SolarInvert-GmbH/inverter_assemblies--powerboard/Sonderteile und Unterbaugruppen/HF Trafo/HF-Trafo RM5 DMBÜ NV_1443021f_CT872001.pdf

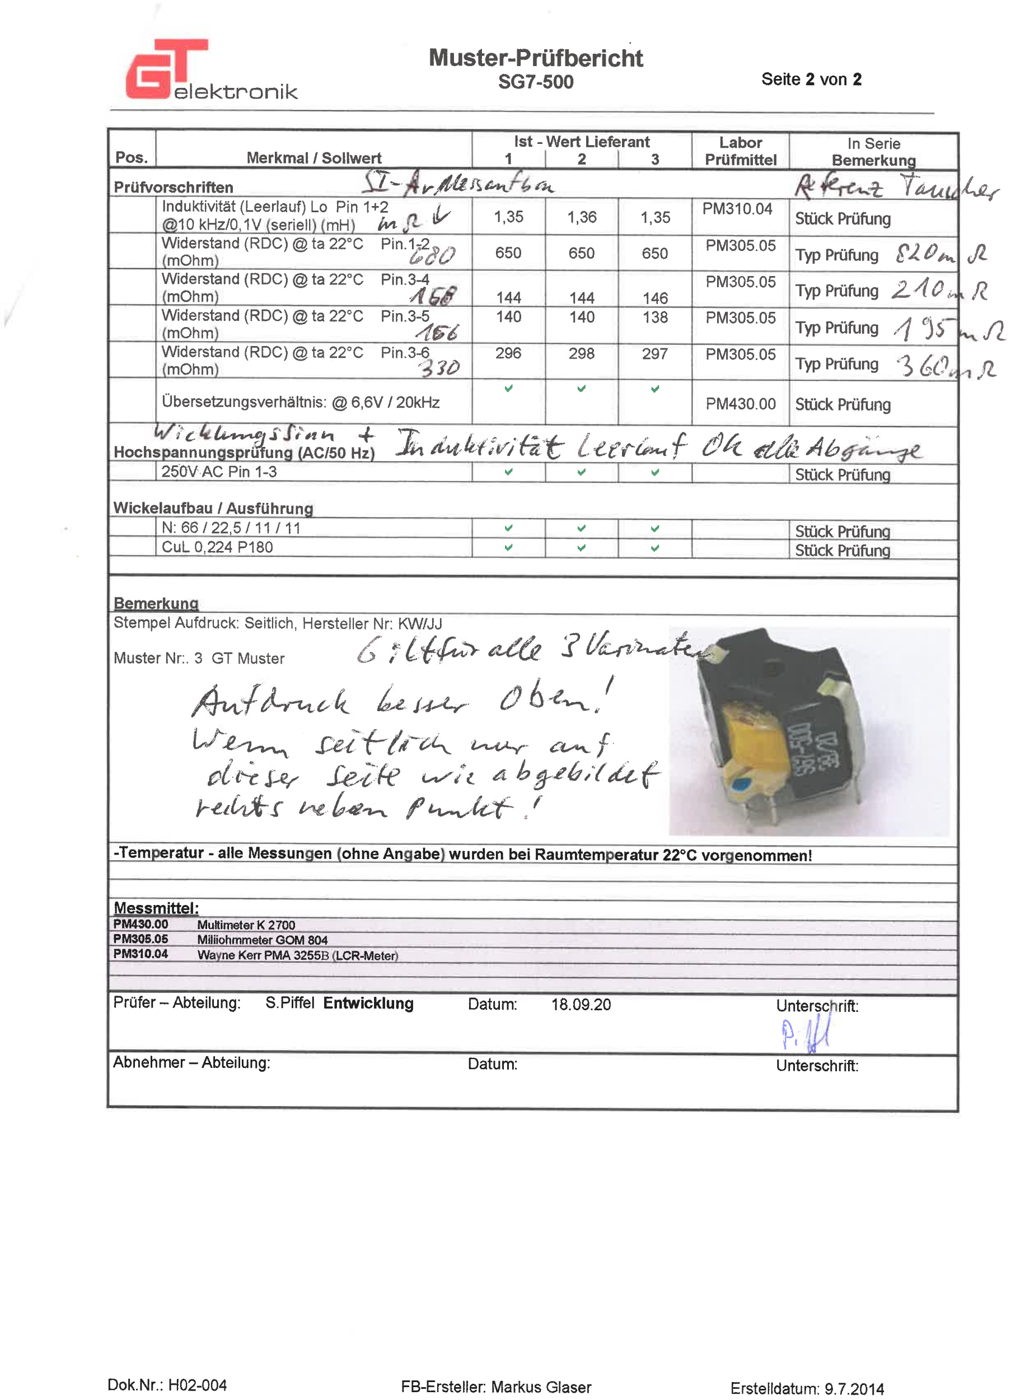
[picture p4: page 1]
