SolarInvert-GmbH/inverter_assemblies--powerboard/Stückliste SOL 2600-60 Leistungsplatine CT902670.017.xls

CT902670 |  | zuletzt gespeichert: | 29.09.2022 |  |  |  |  | Letzte Änderung in | 017
Bestück-Pos. | Menge | Artikel-Name | Artikel-Werte | Bauform | Toleranz | Hersteller | Artikel-Bezeichnung | CT Art.Nr. | Änd-index | Bemerkungen
Leiterkarte | 1 | Leiterkarte Leistungsplatine |  |  |  |  | SI3002V41 | CT300241 | 000 | SMD vorbestückte Leiterplatte Typ NV verwenden
B1 | 0 | SMD- Gleichrichter |  |  |  |  |  |  |  | Wird nur bestückt wenn TR300 bestückt wird
C323 | 1 | Keramik Kondensator | 1nF / 200V | RM5 | +-20% | frei |  | CT851008 | 000 | RoE 20 00 123 8, By2176700; besser den bei C323 generell
 | 0 | Keramik Kondensator | 1nF / 400V | RM5 | +-20% | frei |  | CT851009 |  | RoE 20 03 036 4; Alternativ zu C323
 | 0 | Keramik Kondensator | 1nF /250V | RM5 | +-20% | frei |  | CT851006 |  | Alternativ zu C323
 | 0 | Keramik Kondensator | 1nF / 100V | RM5 | +-20% | frei |  | CT856020 |  | alternativ zu C323 (Freigabe erforderlich)
C309, C314 | 2 | MKS4-/MKT-Kondensator | 10nF / 250V | RM7,5 | +-20% | frei |  | CT856021 | 000 | RoE 20 02 001 5, By2187900
C324, C351, C359 | 3 | MKT-Kondensator | 100nF / 250V | RM7,5 | +-20% | frei | z.B. B32520C3104K B32560J3104K | CT847012 | 000 | RoE 20 02 060 0, By2188200
C343, C344, C387, C389 | 4 | Keramik-Kondensator | 100nF / 200V | RM5,08 | +-20% | frei | z.B. C330C104K2R5TA | CT856022 | 000 | RoE 20 03 022 9, By2188400
C300 | 0 | Keramik-Kondensator | 100nF / 200V | RM5,09 | +-20% | frei |  | CT856022 |  | Alternativ zu C389
C355 | 0 | MKT-Kondensator | 100nF / 250V | RM7,5 | +-20% | frei | z.B. B32520C3104K B32560J3104K | CT847012 |  | Alternativ zu C387
C301, C302, C303, C345, C346, C366, C398, C403 | 8 | Snap in Elko | 6800µF / 100V / 85°-105° | RM 10 | +-20% | frei | Krummer Kondensatoren GmbH DATENBLATT NR.: 313-006149 313ECA100682M035050A | CT856601 | 013 | Isolierung des Elko C346 muss von unten mit Kapton Klebeband beklebt werden, wegen Lotdurchstieg von unten
C301, C302, C303, C345, C346, C366, C398, C403 | 0 | Snap in Elko | 5600µF / 100Volt / 105° | RM 10 | +-20% | Lelon Epcos | LSG562M2A-3060 B41252-A9568-M | CT856600 |  | By2367900 alternativ zu 6800µF/100V Isolierung des Elko C346 muss von unten mit Kapton Klebeband beklebt werden, wegen Lotdurchstieg von unten
C346 | 1 | Isolierscheibe | für Snap In Elkos mit Ø35 und 2 Durchstecklöcher RM10 | RM 10 |  | Krummer Kondensatoren GmbH | TPS 35-2 (TPS- 008821) | CT008821 | 013
C304, C310 | 2 | SMD-Tantal-Kondensator | 10µF / 10V / -55°C ~ 125°C | C | +-20% | frei, AVX KEM | TAJC106K016R T491C106K016AT | CT860006 | 000
C305, C306, C308, C311, C312, C315, C321, C327, C329, C331, C333, C334, C337, C339, C342, C349, C378, C379, | 18 | SMD-Keramik-Kondensator | 100nF / 63V / X7R | 1206 | +-10% | frei |  | CT855009 | 000
C307, C313 | 2 | SMD-Tantal-Kondensator | 2,2µF / 20V | B | ±10% | frei |  | CT856023 | 000
 | 0 | SMD-Tantal-Kondensator | 1µF / 20V | A | ±10% | frei |  | CT860008 |  | alternativ zu C307, C313 (je 2 mal bestückt)
C1, C316, C350, C361, C404 | 5 | MKT- / MKS-4-Kondensator | 22µF / 100V DC | RM 27,5 | +-10% | frei | B32524-Q1226K B32524Q1226K000 MKS4-22/100/10P27 | CT847009 | 000 | RoE 22 02 088 0, By2188800
 | 0 | MKT- / MKS-4-Kondensator | 22µF / 63V DC | RM 27,5 | +-10% | frei | R60DR5220AA30K : Kemet | CT847010 |  | RoE 20 02 053 2 alternative C316, C350, C361, C404
C372 | 1 | Kondensator | 220µF / 25V / 105° / 3000-5000h | RM5 | +-20% | frei, z.B. Panasonic | EEU-FM1V221 EEU-FM1H221 | CT856024 | 000 | RoE 20 01 100 4, By2181900
C318 | 1 | SMD-Keramik-Kondensator | 330nF / 50V / X7R | 1206 | +-20% | AVX Kemet | 12065C334KAT1A C1206C334K5RACTU | CT855024 | 000
C319 | 1 | SMD-Keramik-Kondensator | 330p / 50V / NPO / Flexicap | 0805 | +-10% | frei | z.B. 0805Y1000331JCT | CT855126 | 000
C320 | 1 | SMD-Keramik-Kondensator | 10nF / 50V / X7R / Flexicap | 0805 | +-10% | frei, z.B. AVX | z.B. 08051C103KAZ2A | CT855121 | 000
C322 | 1 | SMD-Keramik-Kondensator | 1nF / 50V / X7R / Flexicap | 0805 | +-10% | frei, z.B. AVX Kemet | z.B. 08055C102KAZ2A C0805X102K5RACTU | CT855119 | 000
C330, C332, C335, C348, C367 | 5 | Al-Elko gepolt | 100µF / 25V / longlife min 5000 h / 6,3x11-11,5mm | RM 2,5 | +-20% | z.B. NIC Lelon Panasonic Panasonic Rubycon | UHE1E101MED1TD RXW101M1ESA0611 EEUFR1E101 EEU-EB1E-101 EEU-EB1E101S YXG100MT1 | CT856002 | 001 | RoE 20 01 085 6, By2182000, By2189000
C374 | 0 | Al-Elko gepolt | 100µF / 20-25V longlife min 5000h | RM5 | +-20% | frei |  | CT856026 | 001 | alternativ zu C367
C388, /C390 bei RM7,5; und C409 | 1 | Al-Elko gepolt | 100µF / 160-200V / 105° | RM7,5 | +-20% | Nichicon Panasonic Panasonic Panasonic | UPW2C101MHD EEU-ED2C101S EEU-EB2C101S EEU-EB2C101 | CT856027 o. CT856029 | 000
C409 | 0 | Al-Elko gepolt | 100µF / 100-200V / 105° | RM5 | +-20% | z.B. Lelon | RGA101M2ASA1020 | CT856012 | 008 | Rückwärtsstart Elko für 7VA Trafo
C326, C328, C336, C338, C340, C341 | 6 | SMD-Tantal-Kondensator | 22µF / 25V / -55 - +125°C | D | +-20% | frei, Vishay Kemet | 293D226X9025D2TE3 T491D226K025AS | CT860007 | 000
C352 | 1 | SMD-Tantal-Kondensator | 1µF / 20V | A | ±10% | frei, AVX Epcos | TAJA105K020R B45196-H5105K109 | CT860008 | 000
C354 | 1 | MKT-Kondensator | 1µF / 250V Kunststoffgehäuse | RM15 | +-20% | AVX Kemet Epcos Epcos Vishay | BN154G0105K R60II4100AA30J B32522N3105J B32522C3105J189 MKT1820510255 | CT847015 | 005 | Achtung: Type B32562J3105K mit Metalgehäuse gesperrt!
C354 | 0 | MKT-Kondensator | 1µF / 100V | RM15 | +-20% |  | MKT1820510255 | CT847016 | 005 | alternative zu C354 RoE 20 02 050 9, By2189300
C356, C357, C383, C384 | 0 | Entstörkondensator | 4,7nF Y1 AC500V | RM15 |  | frei, Vishay |  | CT805198
C370, C371, C376, C377 | 4 | Entstörkondensator | 4,7nF Y1 AC500V | RM10 |  | frei | VY1472M63Y5UQ6TV0 VY1472M63Y5UQ63V0 | CT100105 | 000 | RoE 20 02 084 6, By2189400
C358, C385, C405, C420 | 4 | Entstörkondensator X1 | 330nF X1 330V | RM22,5 | +-20% | frei | B32913A3334M | CT800142 | 017 | C405 ergänzt, RoE 20 02 083 5, By2189500
C369, C375, C406 | 0 | Entstörkondensator X1 | 330nF X1 | RM27,5 | +-20% | frei |  | CT805199 | 017 | alternativ zu C358, C385, C405
C382 | 1 | Entstörkondensator X2 | 680nF X2 275V- 305V | RM27,5 | +-10% | frei | B32924C3684M | CT805200 | 000 | RoE 20 02 082 4, By2189600
C368 | 0 | Entstörkondensator X1 | 330nF X1 | RM22,5 | +-20% | frei | B32913A3334M | CT800142 |  | alternativ zu C382
C360 | 1 | SMD-Tantal-Kondensator | 47nF / 63V | 1206 | +-20% | frei |  | CT800084 | 000
C380 | 0 |  | unbest. | 0805 |  | frei |  | neu |  | nicht bestückt
C381 | 0 |  | unbest. | 0805 |  | frei |  | neu |  | nicht bestückt
C386 | 0 |  | unbest. | 0805 |  | frei |  | neu |  | nicht bestückt
C391 | 1 | SMD Kondensator | 10nF / 200V X7R | 1206 | +20% | frei | Bürklin 46D6593 | CT710231 | 000
C399; C400, C401, C402 | 0 | SMD Kondensator |  | 1812 |  |  |  |  | 006 | nicht bestückt
C392,C419, C396 ,C397 | 0 | SMD Kondensator |  | 2220 |  |  |  |  | 006 | nicht bestückt
CON334 | 0 | Anschlussklemme | Anschlusskl. PTSA 0,5/2-2,5-F, 2polig, 2,5 mm (1989748) |  |  | Bürklin | 09H2220 | CT343095 |  | Wird nicht mehr bestückt und mit R378 gebrückt
CON304, CON305, CON312, CON313, CON314, CON322, CON337, CON338, CON339, CON340, CON341, CON342 | 12 | Anschlussklemme | verzinnt, M5, ohne Schraube |  |  | Keystone | 7807 | CT343092 | 000 | RoE 61 03 430 7, By2189900
 | 0 | Anschlussklemme | verzinnt, M5, mit Schraube |  |  | Keystone | 7808 | CT343093 |  | alternativ zu CON304, CON305, CON312, CON313, CON314, CON322, CON337, CON338, CON339, CON340, CON341, CON342
CON302, CON308, CON309, CON311, CON315, CON317, CON318, CON319, CON320, CON321, CON323, CON325, CON332, CON333 | 14 | Flachstecker | Stift | 6,3x0,8 |  | z.B. Tyco Vogt | 726386-2 08W09 | CT343090 | 000 | RoE 61 03 019 0, By2192200
U$41 | 2 | Flachstecker | Stift | 6,3x0,8 |  | z.B. Tyco Vogt | 726386-2 08W09 | CT343090 | 015 | Im Layout heisst das Steckerfeld nur U$41. Die Richtung sollte so sein wie bei den anderen Flachstecker 6,3x0,8 auch! Ob vorne oder hinten die 3 von den 4 Löchern verwendet werden spielt keine Rolle.
CON335 + CON336 nicht bestücken | 0 | Flachstecker | Stift | 6,3x0,8 |  | z.B. Tyco Vogt | 726386-2 08W09 | CT343090 |  | RoE 61 03 019 0, By2192200
CON303 | 1 | Stiftleiste | 3-polig | RM5 |  | z.B. Stelvio Phoenix | CPM5-3 muss bestückt werden! wegen neuem NA-Schutz! MSTBV2,5/3-GF ist falsch, darf nicht bestückt werden! | CT887012 | 009 | Sauro CIM030A1-SRO gesperrt, da ohne Seitenwand! RoE 61 03 146 1
CON306, CON307 | 2 | Flachstecker | Stift | 2,8x0,8 |  | z.B. Vogt OSTERRATH | 08W09 61-1674-11/0030 LST1506 | CT887009 | 000 | RoE 61 03 020 2, By2199500
X300 | 0 | Schraubklemme | 3-polig | RM 10 |  |  |  |  |  | By
CON316 | 1 | Anschlussklemme | Anschlusskl. PTSA 0,5/3-2,5-F, 3polig, 5,0 mm |  |  | Bürklin | 09H2221 | CT343097 | 000
CON324 | 1 | Anschlussklemme | Anschlusskl. PTSA 0,5/2-2,5-F, 2polig, 2,5 mm |  |  | Bürklin | 09H2220 | CT343095 | 000
CON329 | 1 | Anschlussklemme | Anschlusskl. PTSA 0,5/2-2,5-F, 2polig, 2,5 mm |  |  | Bürklin | 09H2220 | CT343095 | 000 | RoE 61 03 388 9, By2199300 Neu: für LED Kabel, Bestueckposition: LED Pin 1 + 2 mit Vorwiderstand
CT301 | 0 | Stromwandler |  |  |  | Talema, ACME ELECTRIC | AC1050 50A | CT800190 | 000 | RoE 40 00 023 9, By2185300
CT301 | 1 | Stromwandler 2500/1 100A |  |  |  | Talema | ACX1100 | CT801100 | 012 | alternative zu AC1050 CT800190
bei CT301 bestücken | 0 | Kabel H07V-U / 10-16qmm / schwarz | Länge ungebogen: ca. 68mm |  |  | frei | Beistellung an Schwabenelektronik | CT713510 | 001 | By2202200
bei CT301 Drahtbrücke bestücken | 1 | Draht für Wandler 2500-3600er LP | gemäß Zeichung CT713511 Draht für Wandler aus CT713510_ZB_Index_C_16_08_19 |  |  | Hersteller : Schwabenelektronik | Drahtbrücke | CT713511, ist bei Schwabenelektronik bestellt BE2019-67 | 001 | wird an Pos. CT301 mit AC1050 zusammen bestückt
D300, D302, D305, D307, D318, D319, D321, D322, D323, D324, D327, D331, D332, D333, D334, D335, D337 | 17 | SMD-Z-Diode |  | MMELF / SOD80 |  | frei (nicht Diotec) | BZV55C18V | CT813075 | 000
D301, D303, D306, D308, D325, D326 | 6 | SMD-Diode |  | MMELF / SOD80 |  | frei | BAV103 | CT812026 | 007 | D338 + D339 entfernt
D309, D310, D336, D340, D341 | 5 | Diode |  | MMELF / SOD80 |  | z.B. Vishay / frei | LL4148 | CT812024 | 000
D1 | 0 | THT-Diode |  | DO41 |  | z.B. Vishay / frei | 1N4004 bis 1N4007 einsetzbar | CT710035 | 008 | Rückwärtsstart Diode für 7VA Trafo
D311, D320 | 2 | SMD-Schottky-Diode |  | MMELF / SOD80 |  | frei | BAT46 TMMBAT46 | CT801001 | 000
D313 | 1 | SMD-Schottky-Diode |  | SOT-23 |  | frei | BAS70-00-V BAS70-00-V-GS18 BAS70-00-V-GS08 | CT801004 | 000
 | 0 | SMD-Schottky-Diode |  | SOT-23 |  | frei | BAS70-04-V BAS70-04-V-GS18 BAS70-04-V-GS08 | CT710046 |  | Alternative zu D313
 | 0 | SMD-Schottky-Diode |  | SOT-23 |  | frei | BAS70-05-V BAS70-05-V-GS18 BAS70-05-V-GS08 | CT710047 |  | Alternative zu D313
D314, D315 | 2 | SMD-Schottky-Diode |  | SOT-23 |  | frei | BAT64 | CT801005 | 000
D328, D329 | 2 | SMD-Z-Diode | 4V7 | MMELF / SOD80 |  | frei (außer Diotec!) | BZV55C4V7 TZMC4V7-GS08 | CT813080 | 000
D330 | 1 | SMD-Z-Diode | 5,6V/ 0,5W | MMELF / SOD80 |  | frei | TZMC5V6-GS08 | CT813079 | 000
DR301 | 1 | Stromkompensierte DC-Ringkerndrossel | 2x3mH / 40A | stehend |  |  | Talema 21859 (HF-Litze) oder Talema 21958 (Drahtausführung) | CT866333 CT866332 | 011 | By2185100
DR302 | 1 | AC-Ringkern-Speicherdrossel | 2x27µH / 75A | stehend |  |  | Talema 21858 (HF-Litze) oder Talema 21957 (Drahtausführung) | CT866222 CT866232 | 011 | RoE66 00 006 8, By2185000
Schraube | 2 | Linsenschraube mit Torx | M4x10, A2, ISO 14583 |  |  |  | sind M4x10 und nicht M4x12! | CT600015 | 015 | bei Grundplatte DR302; Nähe C316 + C303 Drossel wird auf LP geschraubt vor dem Wellenlöten
Mutter | 2 | Mutter | M4, A2, DIN 934 |  |  |  |  | CT600017 | 000 | bei Grundplatte DR302 Drossel wird auf LP geschraubt vor dem Wellenlöten
DR303 | 1 | Netz-Ringkerndrossel | 2x3,3mH/12A/BF2; 2x3mH/12A; 2x2,5mH/12,5A |  |  | frei, z.B. Epcos | B82726S6123N020 | CT710230 | 000 | By2184500: Nr. nicht bekannt!!!; By2348100: THT Entstördrossel 2x3mH/12A/BF2 RB8522-16-3MO; By2350700: THT Entstördrossel 2x2,5mH/12,5A 8114-RC (BOURNS)
F301 | 1 | G-Sicherung | Sicherungseinsatz 5x20 16A Träge | 5x20 |  | z.B. Eska | Typ 522.030 16A | CT800118 | 000 | Sicherung erst nach dem Löten einsetzen By2254200
F303 | 0 | PTC Sicherung |  | RM5 |  |  |  |  |  | Wird nur bestückt wenn TR300 bestückt wird
IC301, IC302 | 2 | SMD - IC |  | SO-16L |  | IRF | IR2110SPBF | CT818010 | 000
 | 0 | SMD - IC |  | SO-16L |  | IRF | IR2113ST-IR/N | CT818011 |  | Alternativ zu IC301, IC302
IC305 | 1 | SMD - IC |  | SO-14 |  | TI On Semi | UC2843D UC2843BDG | CT819009 | 000
IC307 | 1 | SMD - IC |  | SO-14 |  | ST Microelectronics NXP Fairchild ST Microelectronics | HCF4093M HEF4093 CD4093BCM HCF4093BM1 | CT818007 | 000
K301, K302, K303 | 3 | Netztrenn-Relais | RT424012, 12V 8A 1xWechsler |  |  | Tyco | 6-1393243-3 | CT862010 | 000 | RoE 51 30 040 3; By2201300
K307 | 1 | Signalrelais | G5V-1 12VDC, 12 VDC, 960 Ohm |  |  | Panasonic / OMRON; Bürklin 29 G 8562 | G5V-1 12VDC | CT710556 | 000
L300, L302 | 2 | SMD-Spule SIMID02 | 22µH, 145mA | 1210 |  | Murata Epcos Epcos | LQH32CN220K23L B82422-A1223-K000 B82422-A1223-K100 | CT866001 | 000
L301 | 1 | SMD-Spule SIMID03 | 22µH, 260mA | 1812 |  | Murata Epcos | LQH43CN220K03L B82432C1223K | CT866002 | 000
 | 0 | SMD-Spule SIMID03 | 22µH, 450mA | 1812 |  | Epcos | B82432T1223K | CT866003 |  | Alternativ zu L301 (Freigabe erforderlich)
P301, P302, P303, P304 | 4 | Poti | Poti 22K 0,5W |  |  | z.B. Vishay | T93YAK022 | CT840011 | 000 | RoE 10 30 051 0, By2200100
P305 | 1 | Poti | Poti 100R 0,5W |  |  | z.B. Vishay | T93YAE100; T93YA101; T93YA100R | CT710233; CT710239 | 000 | RoE 10 30 051 1, By2200200
R1 | 0 | Metallschichtwid. | 5R1 / 0,6W | 0207 THT stehend | +-1% | frei |  |  |  | Wird nur bestückt wenn TR300 bestückt wird
R395 | 1 | Metallschichtwid. | 12R / 0,6W | 0207 THT | +-1% | frei |  | CT840032 | 000 | RoE 10 00 238 4, By2200300
 | 0 | Metallschichtwid. | 11R / 0,6W | 0207 THT | +-1% | frei | BÜ 30 E 104 | CT840110 |  | alternative zu R395
R373, R374 | 2 | Metallschichtwid. | 100k / 0,6W | 0207 THT | +-1% | frei |  | CT829005 | 000 | werden liegend bestückt
R304, R351, R352, R362 | 4 | SMD-Widerstand | 16R | 0805 | +-1% | frei |  | CT827192 | 016 | RoE 10 10 286 8; 4er Gruppen werden bei manchen Platinen mit unterschiedlichen Werten bestückt
R300, R305, R328, R350 | 4 | SMD-Widerstand | 16R | 0805 | +-1% | frei |  | CT827192 | 016
R301, R327, R329, R330 | 4 | SMD-Widerstand | 22R | 0805 | +-1% | frei |  | CT827150 | 000
R391, R392, R393, R394 | 4 | SMD-Widerstand | 22R | 0805 | +-1% | frei |  | CT827150 | 006
R302, R306, R309, R312, R320, R332, R354, R363, R369, R377 | 10 | SMD-Widerstand | 100k | 0805 | +-1% | frei |  | CT827136 | 001
R316 | 1 | SMD-Widerstand | 82K 1% 0,125W | 0805 | +-1% |  |  | CT827120 | 000
R308, R340, R404 | 3 | SMD-Widerstand | 1k | 0805 | +-1% | frei |  | CT827002 | 000 | RoE 10 10 055 2; ab 2.221V12
R310 | 1 | SMD-Widerstand | 5K1 1% 0,125W | 0805 | +-1% | frei |  | CT827145 | 000 | R365 =Überspannungsmessung
R333, R337, R365, R368, R375, R382, R383 | 7 | SMD-Widerstand | 10K | 0805 | +-1% | frei |  | CT827122 | 014 | R370, R367entfernt!
R356, R357 | 2 | SMD-Widerstand | 22k | 0805 | +-1% | frei |  | CT827140 | 000
R313 | 1 | SMD-Widerstand | 51k | 0805 | +-1% | frei |  | CT827153 | 000
R314 | 1 | SMD-Widerstand | 330k | 0805 | +-1% | frei |  | CT827155 | 000
R315 | 1 | SMD-Widerstand | 27k | 0805 | +-1% | frei |  | CT827151 | 000
R317 | 1 | SMD-Widerstand | 2k7 | 0805 | +-1% | frei |  | CT827152 | 000
R319 | 1 | SMD-Widerstand | 5R6 | MMELF / 0204 | +-1% | frei |  | CT827154 | 000
R334 | 1 | SMD-Widerstand | 110K 1% 0,125W | 0805 | +-1% | frei |  | CT827218 | 000 | RoE 10 10 344 3
R335, R346, R347 | 3 | Widerstand | 1k5 / 5W | RM5 | +-5% | frei, z.B. Tyco | z.B. SQMR51K5J (1623782-5) SQM51K5J | CT825015 | 000
R336, R341, R364, R372 | 4 | SMD-Widerstand | 1M | 0805 | +-1% | frei |  | CT827139 | 000
R338, R339 | 2 | SMD-Widerstand | 200k | 0805 | +-1% | frei |  | CT827176 | 016
R342 | 1 | SMD-Widerstand | 180k 1% 0,125W | 0805 | +-1% | frei |  | CT827174 | 000
R343 | 1 | Drahtwiderstand | 330R / 5W | axial | +-5% | frei Vishay | AC05000003300JAC00 | CT710226 | 000 | RoE 10 00 236 2, By2200700
 | 1,5 mm | Schrumpfschlauch | Schrumpfschlauch 2:1 1,6mm schwarz |  |  | z.B. Schukat | WSQ16SW-150 | CT710240 | 000 | auf Drahtwiderstand R343 RoE 64 40 008 2
R348 | 1 | SMD-Widerstand | 82K Typ 1% 0,125W | 0805 | +-1% |  |  | CT827120 | 000 | Wird je nach Trafo bestückt; Unetz Reduzierung
R353 | 1 | SMD-Widerstand | 1k2 / 0,25W | 1206 |  | frei |  | CT800103 | 000
R355 | 1 | Metallschichtwiderstand | 47R5 / 0,6W | 0207 THT | +-1% | frei |  | CT840036 | 000 | RoE 10 00 230 6, By2200400 werden stehend bestückt R398 wird nicht bestückt
R358, R359, R360, R361 | 4 | Metallschichtwiderstand | 15k / 0,6W | 0207 THT | +-1% | frei |  | CT840034 | 000 | By1173200
R366, R367 | 2 | SMD-Widerstand | 1k | 0805 | +-1% | frei |  | CT827002 | 000 | R367 dazu; analog in
R371 | 1 | SMD-Widerstand | 10K | 0805 | +-1% | frei |  | CT827122 | 014 | LED bei neuer Steuerplatine / Dann wird R370 nicht bestückt
R376, R378 | 2 | SMD-Widerstand | 0R | 0805 | +-1% | frei |  | CT827122 | 000
R379 | 1 | SMD-Widerstand | 18R / 0,25W | 0805 | +-5% | frei |  | CT827126 | 000
R380 | 1 | SMD-Widerstand | 39R | 0805 | +-1% | frei |  | CT710235 | 000
R381 | 1 | SMD-Widerstand | 270R | 0805 | +-1% | frei |  | CT827234 | 000
R384 | 1 | SMD-Widerstand | 47R | 0805 | +-1% | frei |  | CT710347 | 000
R396, R397 | 0 | SMD-Widerstand | 0R | 0805 | +-1% | frei |  | CT827076 |  | wird nicht bestückt! Nur einer von beiden wird nur bestückt wenn TR300 bestückt wird
R403 | 0 | SMD-Widerstand | 27k | 0805 | +-1% | frei |  | CT827151 | 006 | nicht bestückt
R405 | 0 | Widerstand | 100R / 5W | RM5 | +-10% | frei, z.B. Tyco | z.B. SQMR5100 | CT825012 | 008 | nicht bestückt; für 7VA Trafo Rückwärtsstart
T301, T304, T305, T311 | 4 | SMD-MOSFET N-Kanal |  | SOT-23 |  | NXP ON Semi | BSS123 BSS123LT1G | CT806011
T307, T312 | 0 | SMD Trans. MOSFET |  | SOT-223 |  | IRF Vishay | IRFL214 | CT806015-abgekündigt | 003
T312 | 1 | SMD Trans. MOSFET |  | SOT-223 |  | IRF Vishay | IPN50R3K0CE | CT806015-neu | 003 | Alternativ zu T312, (als T307 vorerst gesperrt)
 | 0 | SMD Trans. MOSFET |  | SOT-223 |  | Infoneon | BSP297 | CT806018 |  | Alternativ zu T312, (als T307 gesperrt)
 | 0 | SMD Trans. MOSFET |  | SOT-223 |  | Infoneon | SPN02N60C3 | CT806019 |  | Alternativ zu T312, T307 (Freigabe erforderlich)
T306 | 1 | SMD Trans. MOSFET |  | D2Pack / TO252AA |  |  | IRFR420PBF | CT847062 | 002 | Alternativ zu T307 (Freigabe erteilt)
TRA302 | 1 | HF-Trafo NV RM5 1,3mH | gem. Datenblatt HF-Trafo RM5 DMBÜ NV_1443021f _CT872001.pdf | 6Pin |  | Tauscher, Pikatron | 1443021f, ÜP 3709 | CT872001 | 000 | RoE 30 00 038 4, By2185200 Bitte Bestückrichtung beachten, Farbpunkt und Dreieck müssen nach außen zeigen‎!
U301 | 1 | SMD-Spannungsregler |  | SO-8 | +-1% | Micrel | MIC5201-5.0YM | CT819007 | 000 | günstigere Type suchen wenn es die neue ST gibt; STM: L4988D
VARI302, VARI303 | 2 | Varistor S25K130 | 130V | RM12,5 |  | z.B Epcos | B72225-S4131-K101 | CT830041 | 000 | By2281400
VARI304, VARI305 | 0 | Varistor S20K95 oder 20D151K |  | RM10 |  | z.B Epcos | B72220-S0950-K101 CNR-20D151K | CT830045 |  | RoE 66 03 068 9 alternativ zu VARI302, VARI303
 | 0 | Varistor S20K115 |  | RM10 |  | z.B Epcos | B72220-S0111-K101 | CT830046 |  | alternativ zu VARI304, VARI305
VARI308 | 1 | Varistor S20K275 |  | RM10 |  | z.B Epcos | B72220-S271-K101 20N431 | CT800093 | 000 | 275V Typ bevorzugt, By2281300
 | 0 | Varistor S20K250 |  | RM10 |  | z.B Epcos | B72220-S251-K101 | CT800110 |  | RoE 66 03 057 7; Alternativ zu VARI308 (Freigabe erforderlich)
VARI309 | 0 | Varistor S14K250 |  | RM7,5 |  | z.B Epcos | B72214-S0251-K101 | CT830047 |  | gesperrt
 | 0 | Varistor S14K275 |  | RM7,5 |  | z.B Epcos | B72214-S0271-K101 | CT830048 |  | Alternativ zu VARI309, gesperrt
CON301 | 1 | Sockel für Steuerplatine 30 polig (neu 2019 für SOL WR) | THT Buchsenleiste 30-polig einreihig RM2,54 BL 5/30/Z, gerade H=7mm | RM 2,54 |  | z.B CONNFLY | DS1002-03-1*30131 (TME - ZL307-1X30) | CT307130 | 014 | Goldkontakte, 30 polige, von PIN 1 her bestücken! By2628000
CON301 | 0 | Steuerplatine co_BOM_ST24 024 | Unterbaugruppe |  |  |  |  | CT349062
 | 0 | Steuerplatine 2.01 | Unterbaugruppe |  |  |  |  | CT702061
 | 0 | Steuerplatine SOL 2000-70 | Unterbaugruppe |  |  |  |  | CT702099 |  | alternativ zu CON301 Bestueckposition: LED Pin 1 + 2 mit Vorwiderstand Steuerplatine Pin 1-16
 | 1 | Stückliste Kühlplatte M3_16x_CT600092 mit MOSFETs FDP075N15 | Unterbaugruppe mit MOSFETs FDP075N15 (oder IPP075N15) |  |  |  |  | CT183061 | 001 | Mosfets IPP und FDP dürfen auf einer Kühlplatte nicht gemischt werden!!!
