SolarInvert-GmbH/inverter_assemblies--powerboard/Sonderteile und Unterbaugruppen/Kühlplatte/Stückliste Kühlplatte M3_16x_CT600092 mit MOSFETs FDP075N15 CT183061.002.xls

CT183061.002 |  | zuletzt gespeichert: | 21.02.2022
Bestück-Pos. | Menge | Artikel-Name | Artikel-Werte | Bauform | Toleranz | Hersteller | Artikel-Bezeichnung | CT Art.Nr. | Änd-index | Bemerkungen
 | 1 | Kühlplatte für MOSFETs für Unterbaugruppe CT183061 | Kühlplatte_2800er_Alu_M3_16x_CT600092_Index2 |  |  |  |  | CT600092 | 000
Q301 , Q302, Q303, Q304, Q305, Q306, Q307, Q308, Q309, Q310, Q311, Q312, Q313, Q314, Q315, Q316 | 16 | N-KANAL POWER MOSFET für Unterbaugruppe CT183061 | 150V, 130A, RDS=0.006 | TO220 |  | IR | FDP075N15 | CT847071 | 002 | Mosfets IPP und FDP dürfen auf einer Kühlplatte nicht gemischt werden!!! IPP075N15 hat die CT847072
 | 16 | Halbleiterbefestigung für MOSFETs |  | für TO220 |  | Fischer Elektronik | ISP 220 V | CT800097 | 000
 | 1 | Isolierfolie 300x31x0,25mm n. Zeichnung Isolierfolie_2800er_Ø3_16x_CT346061_WLF86-82 | WLF86/82 RoHS 16 Löcher zu je 3,0mm, Abstand jeweils zur Lochmitte 12 mm | 300x31x0,225mm |  | Alfatec |  | CT346061 | 001
 | 16 | Schraube | Sechsk.schr. 8.8, M3x16, Zn, DIN 933 |  |  | frei |  | CT397074 | 000
 | 16 | Federscheibe gewölbt | M3, Zn , DIN 137 |  |  | frei |  | CT600040 | 000
