SolarInvert-GmbH/inverter_assemblies--powerboard/Bestückungsplan/Bestückungsplan_BOTTOM.pdf

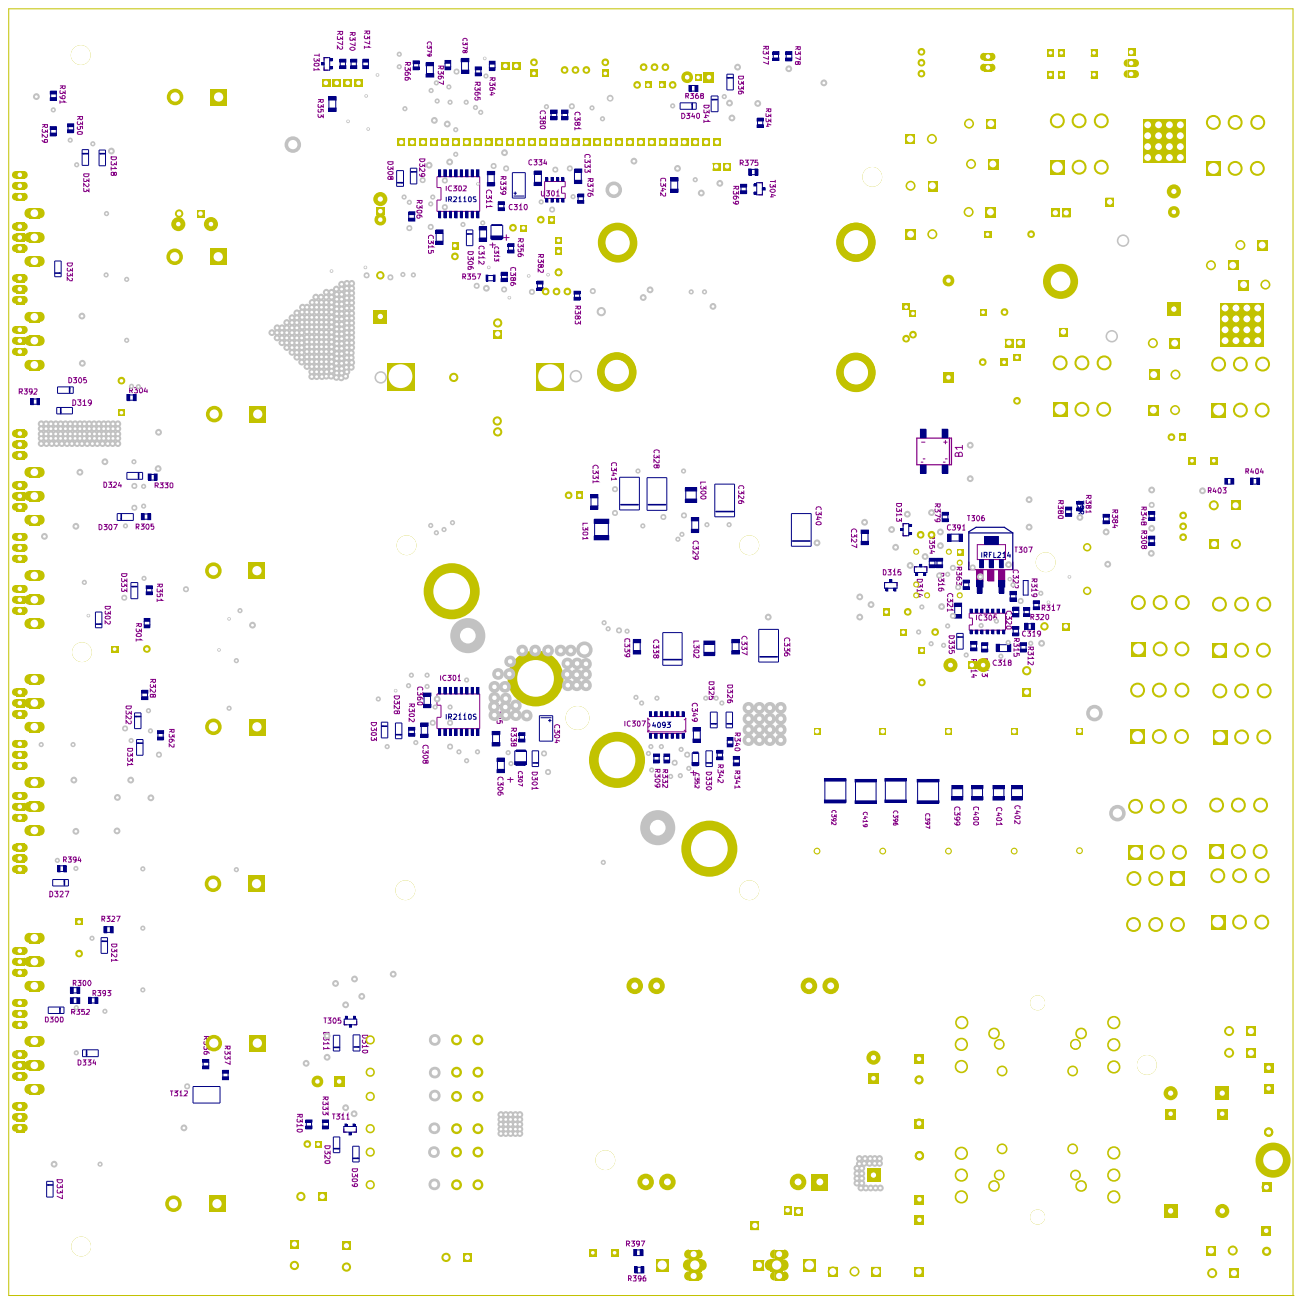
[picture p5: page 1]
