SolarInvert-GmbH/inverter_assemblies--powerboard/Bestückungsplan/Bestückungsplan_TOP.pdf

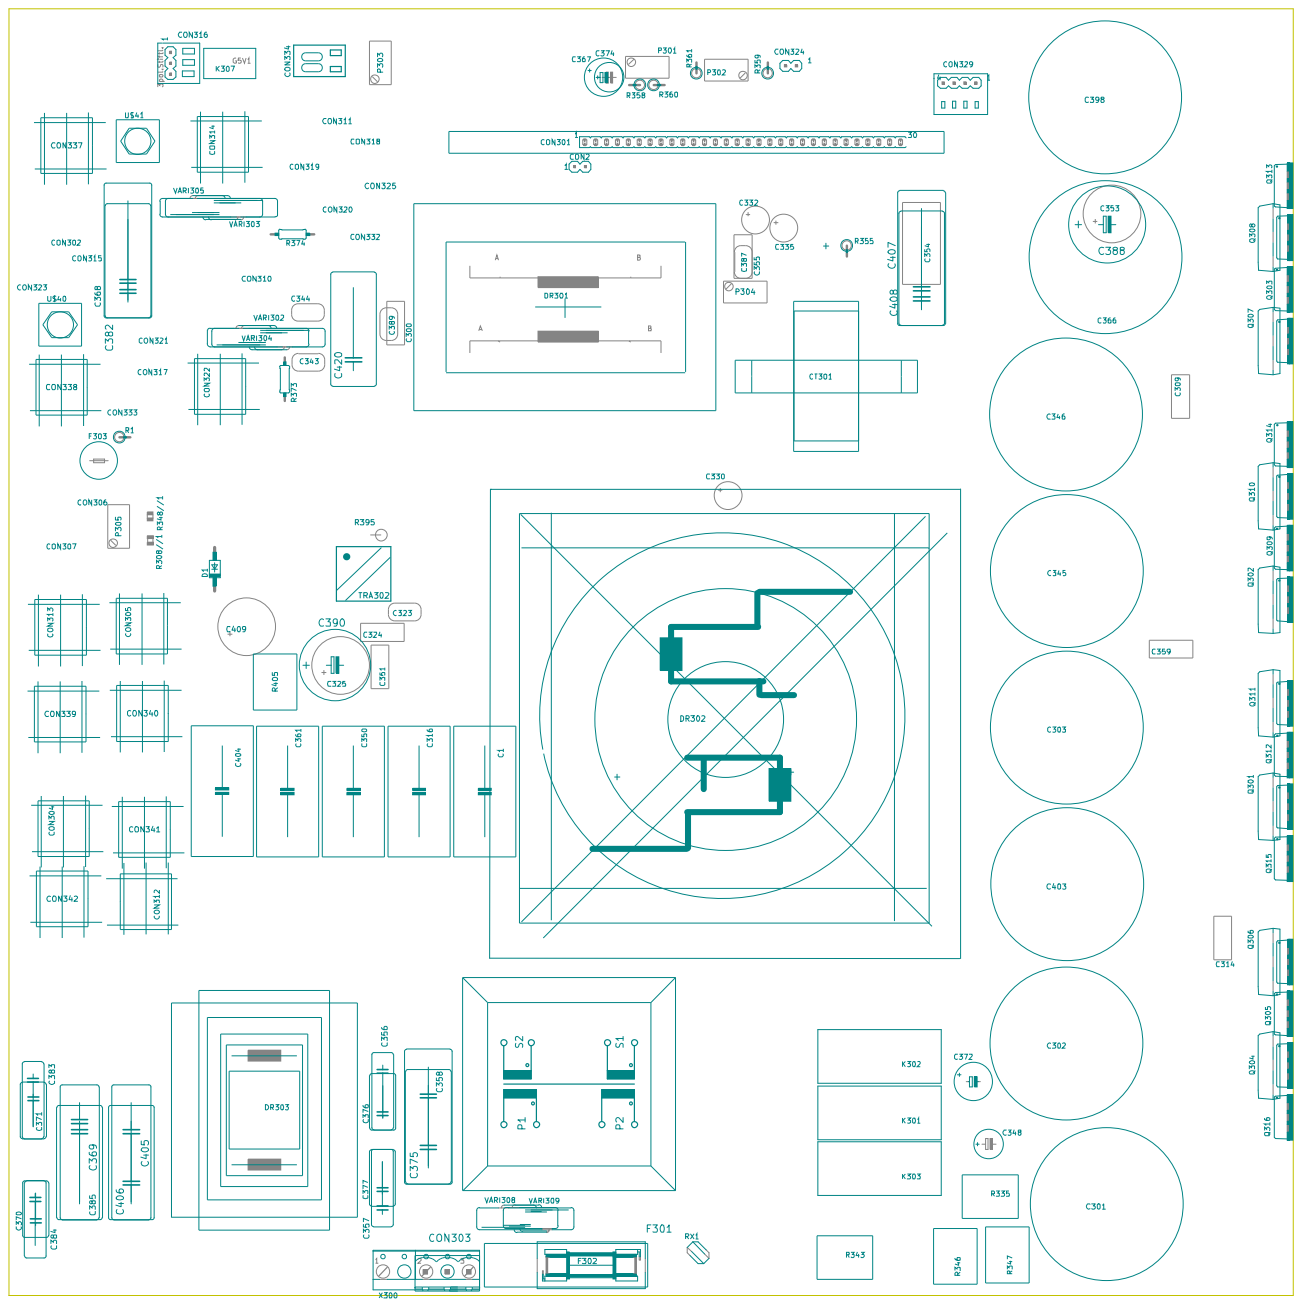
[picture p6: page 1]
