SolarInvert-GmbH/inverter_assemblies--powerboard/Bestückungsplan/Bestückungsplan_TOP_mit_DurKos.pdf

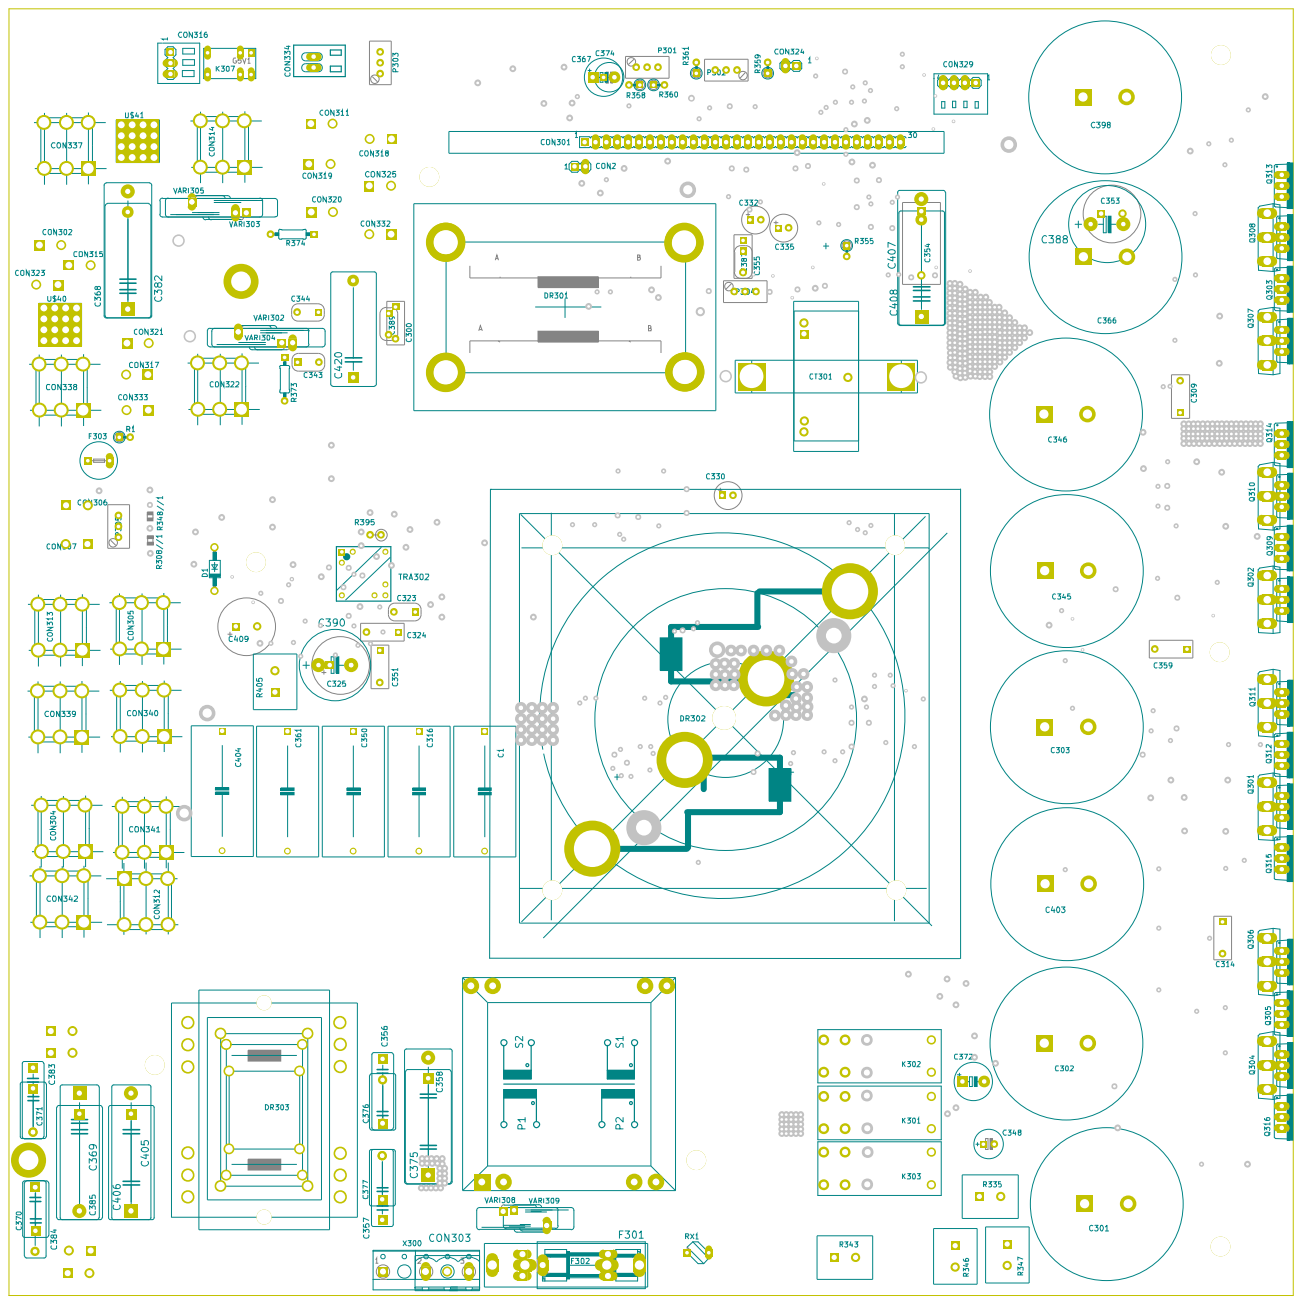
[picture p7: page 1]
