SolarInvert-GmbH/inverter_assemblies--powerboard/Schaltplan/SI3002V4.1.pdf

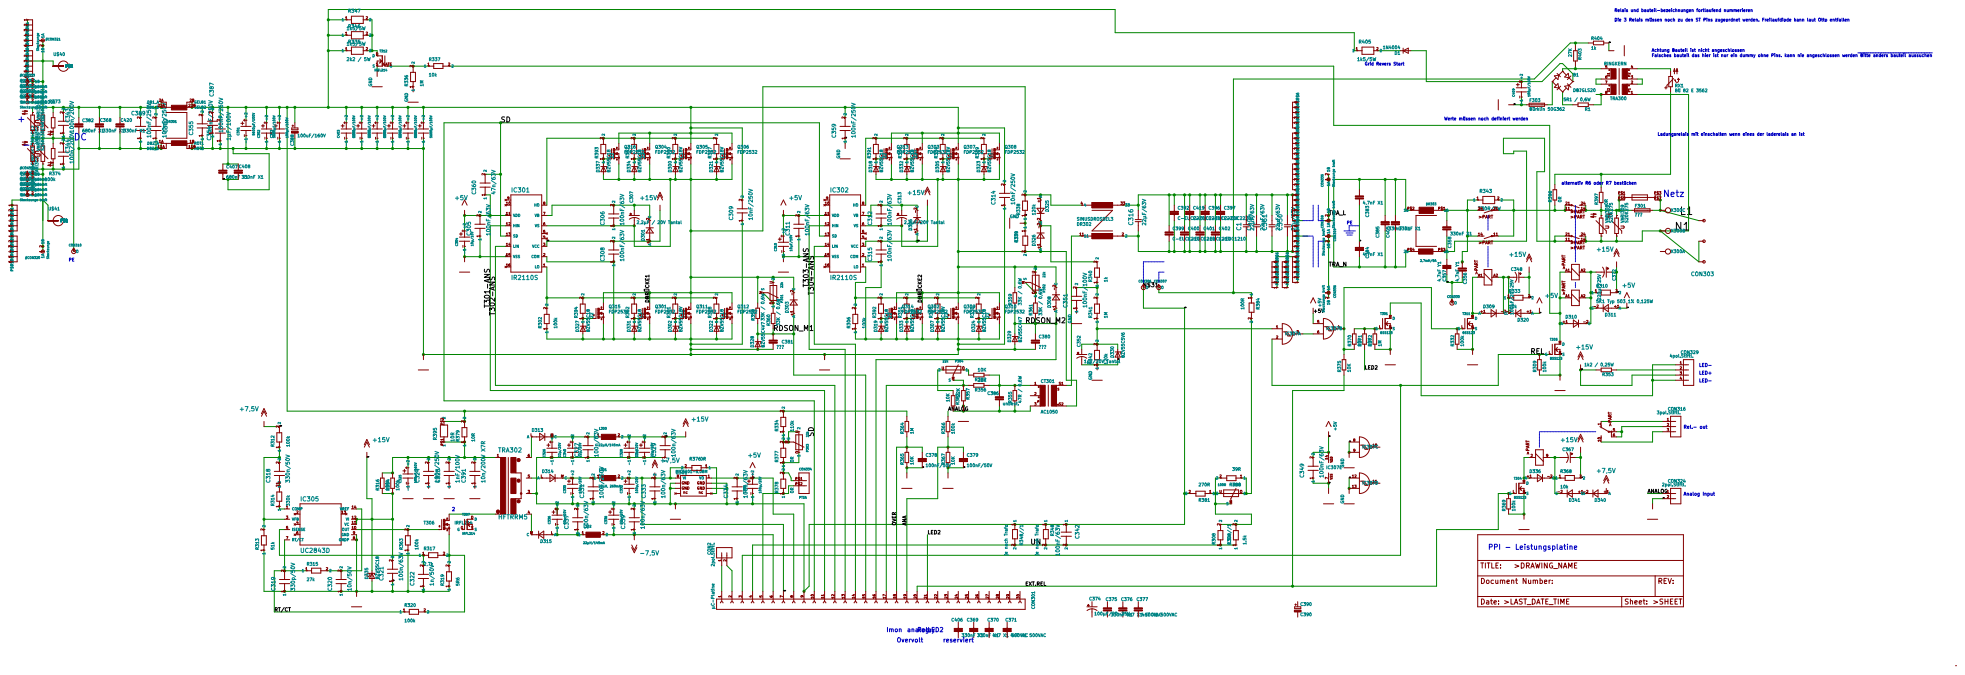
[picture p8: page 1]

Relais und bauteil-bezeichnungen fortlaufend nummerieren

alternativ R6 oder R7 bestücken Die 3 Relais müssen noch zu den ST Pins zugeordnet werden. Freilaufdiode kann laut Otto entfallen

Achtung Bauteil ist nicht angeschlossen

2 R348 je nach Trafo >PART A1 A2 >PART

9101112131415161718192021222324252627282930 CON301 µC-Platine >PART A1 A2 >PART
