SolarInvert-GmbH/inverter_assemblies--powerboard/Sonderteile und Unterbaugruppen/Drahtbrücke/CT713511 Drahtbrücke für Wandler.pdf

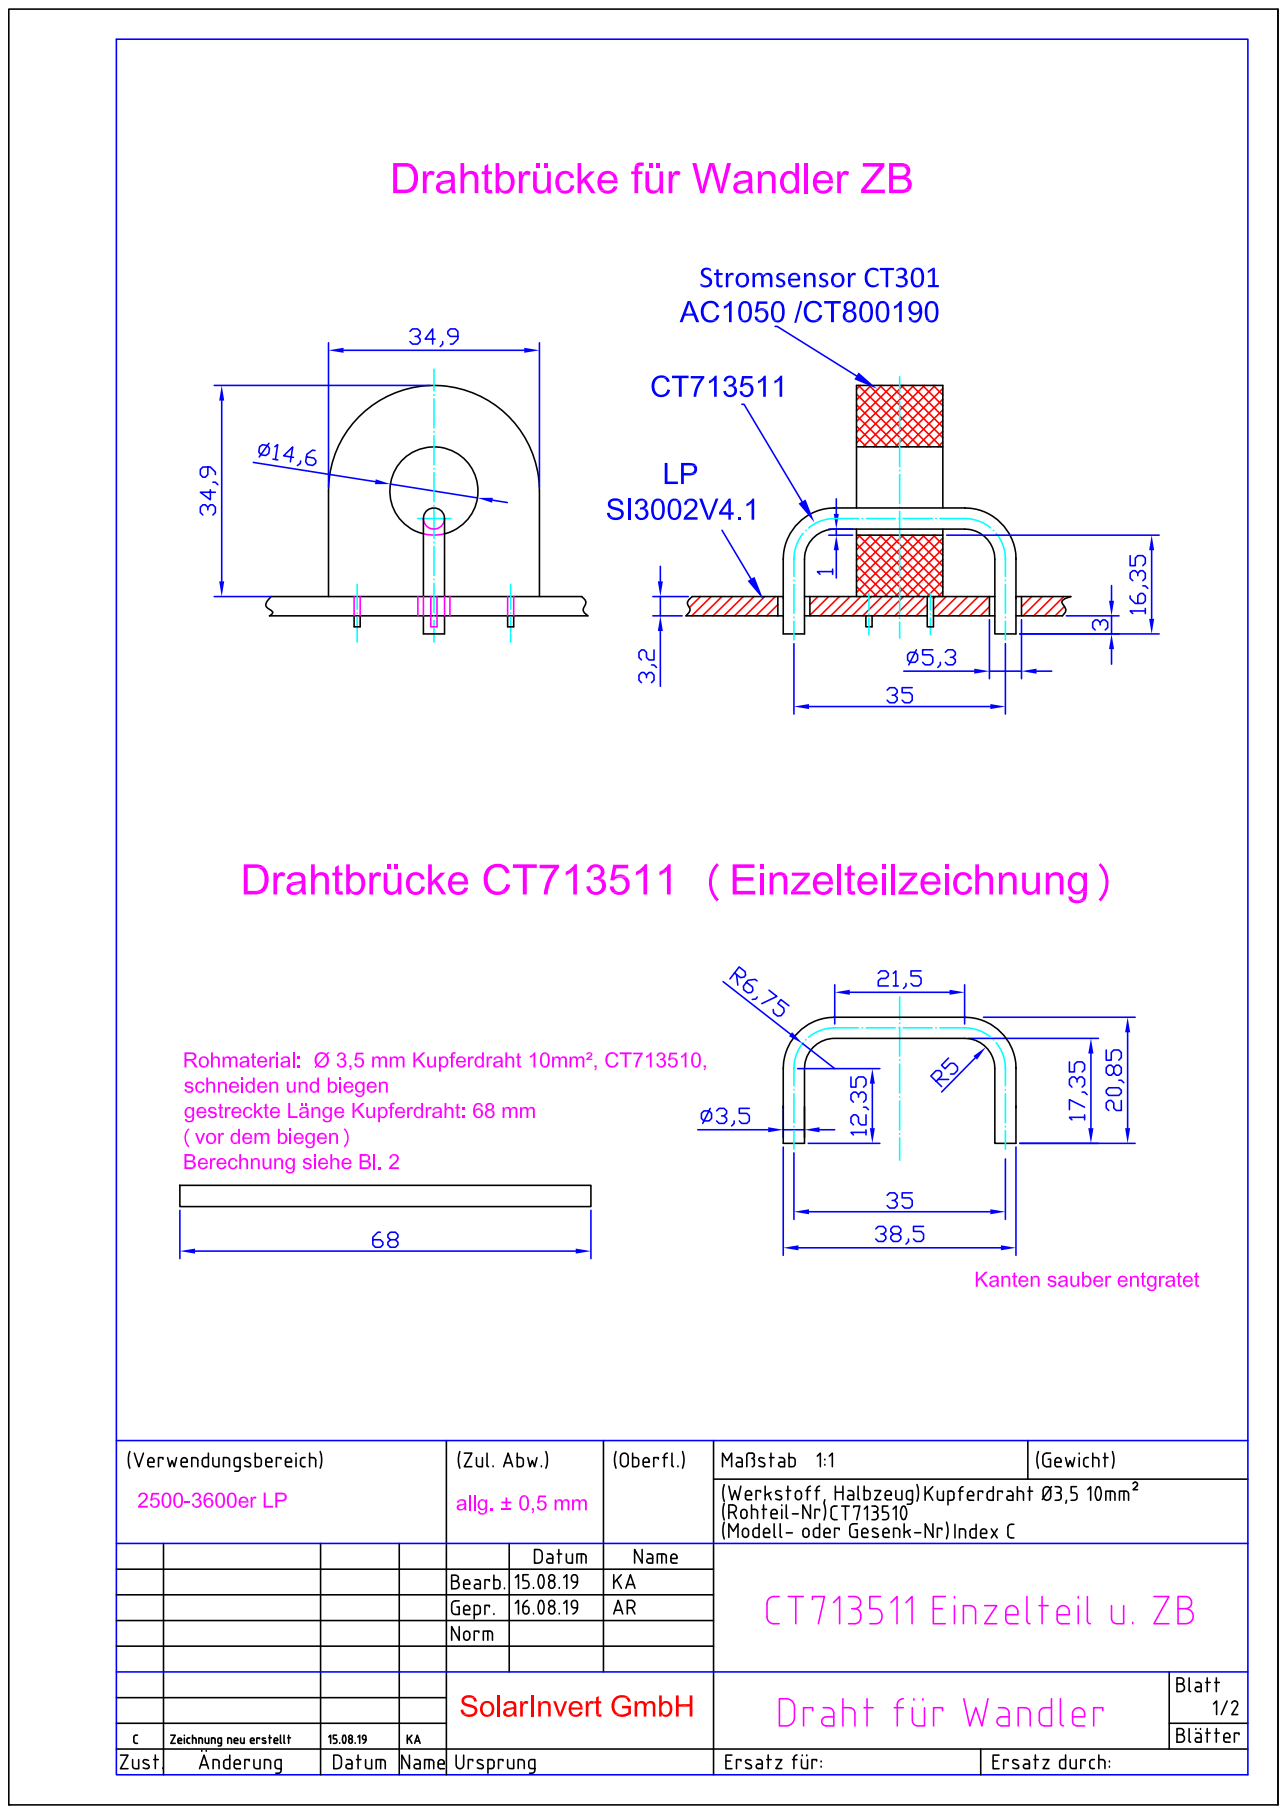
[picture p9: page 1]

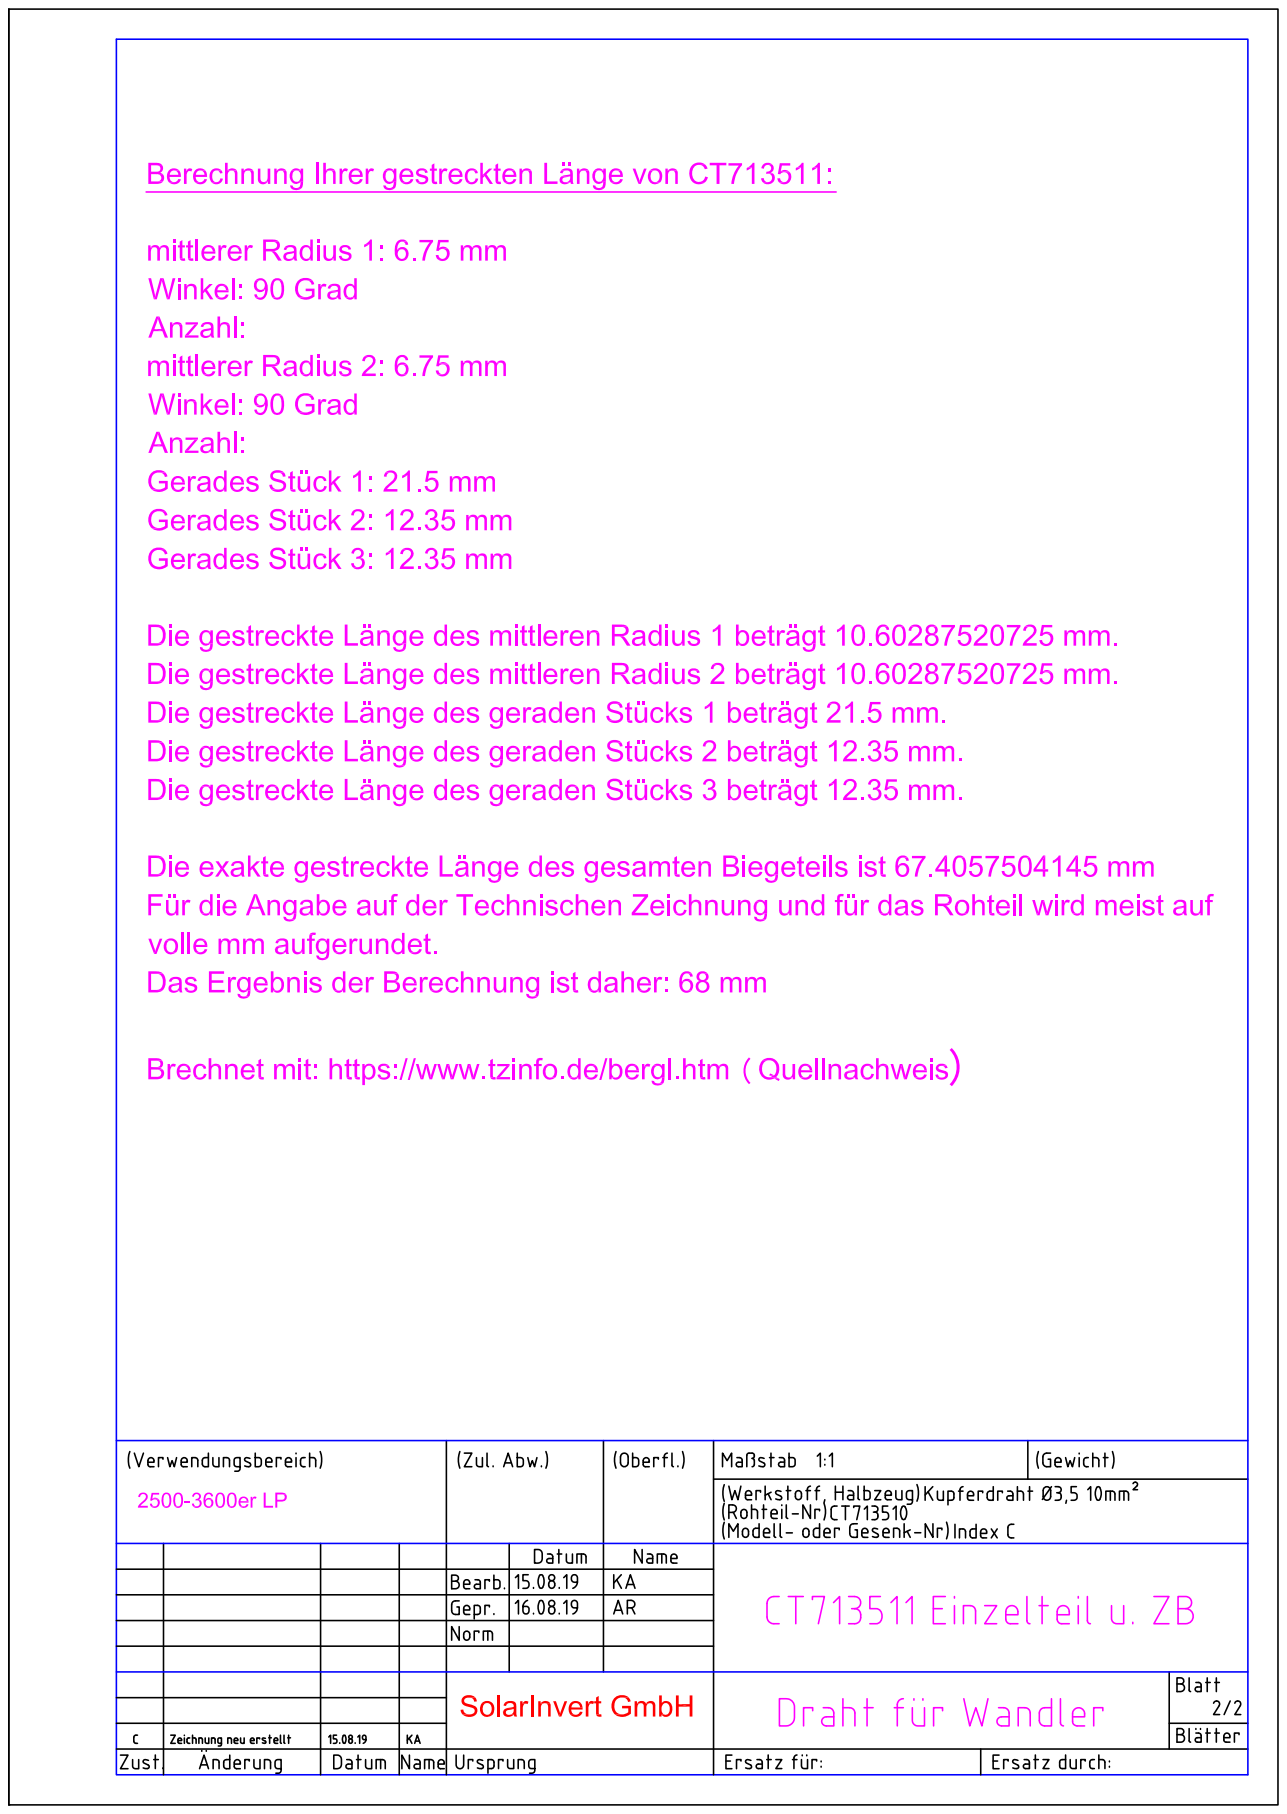
[picture p10: page 2]
