SolarInvert-GmbH/inverter_assemblies--powerboard/Sonderteile und Unterbaugruppen/Kühlplatte/Isolierfolie_2800er_Ø3_16x_CT346061_WLF86-82o. 86-60.pdf

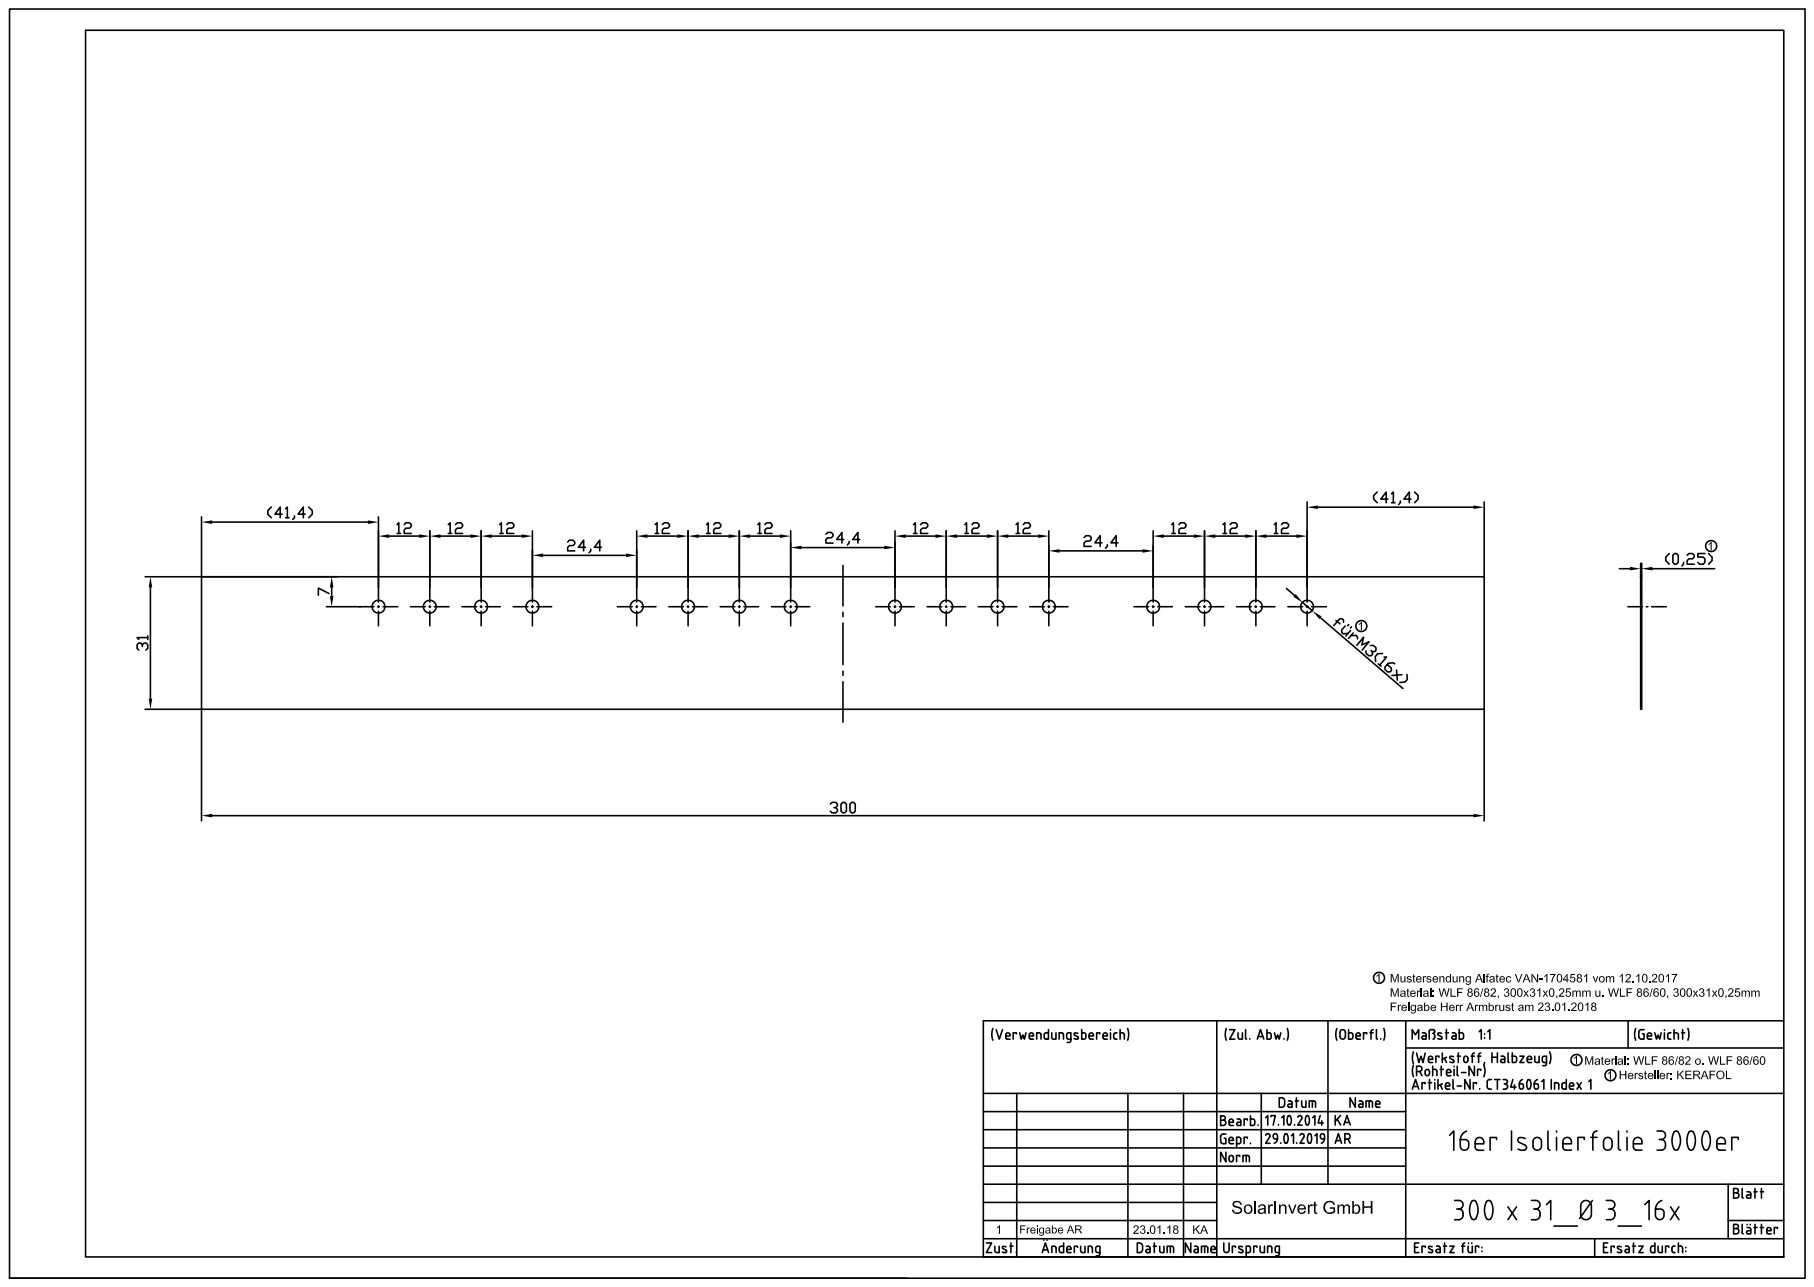
[picture p11: page 1]
