SolarInvert-GmbH/inverter_assemblies--powerboard/Sonderteile und Unterbaugruppen/Kühlplatte/Kühlplatte_2800er_Alu_M3_16x_CT600092_Index2.pdf

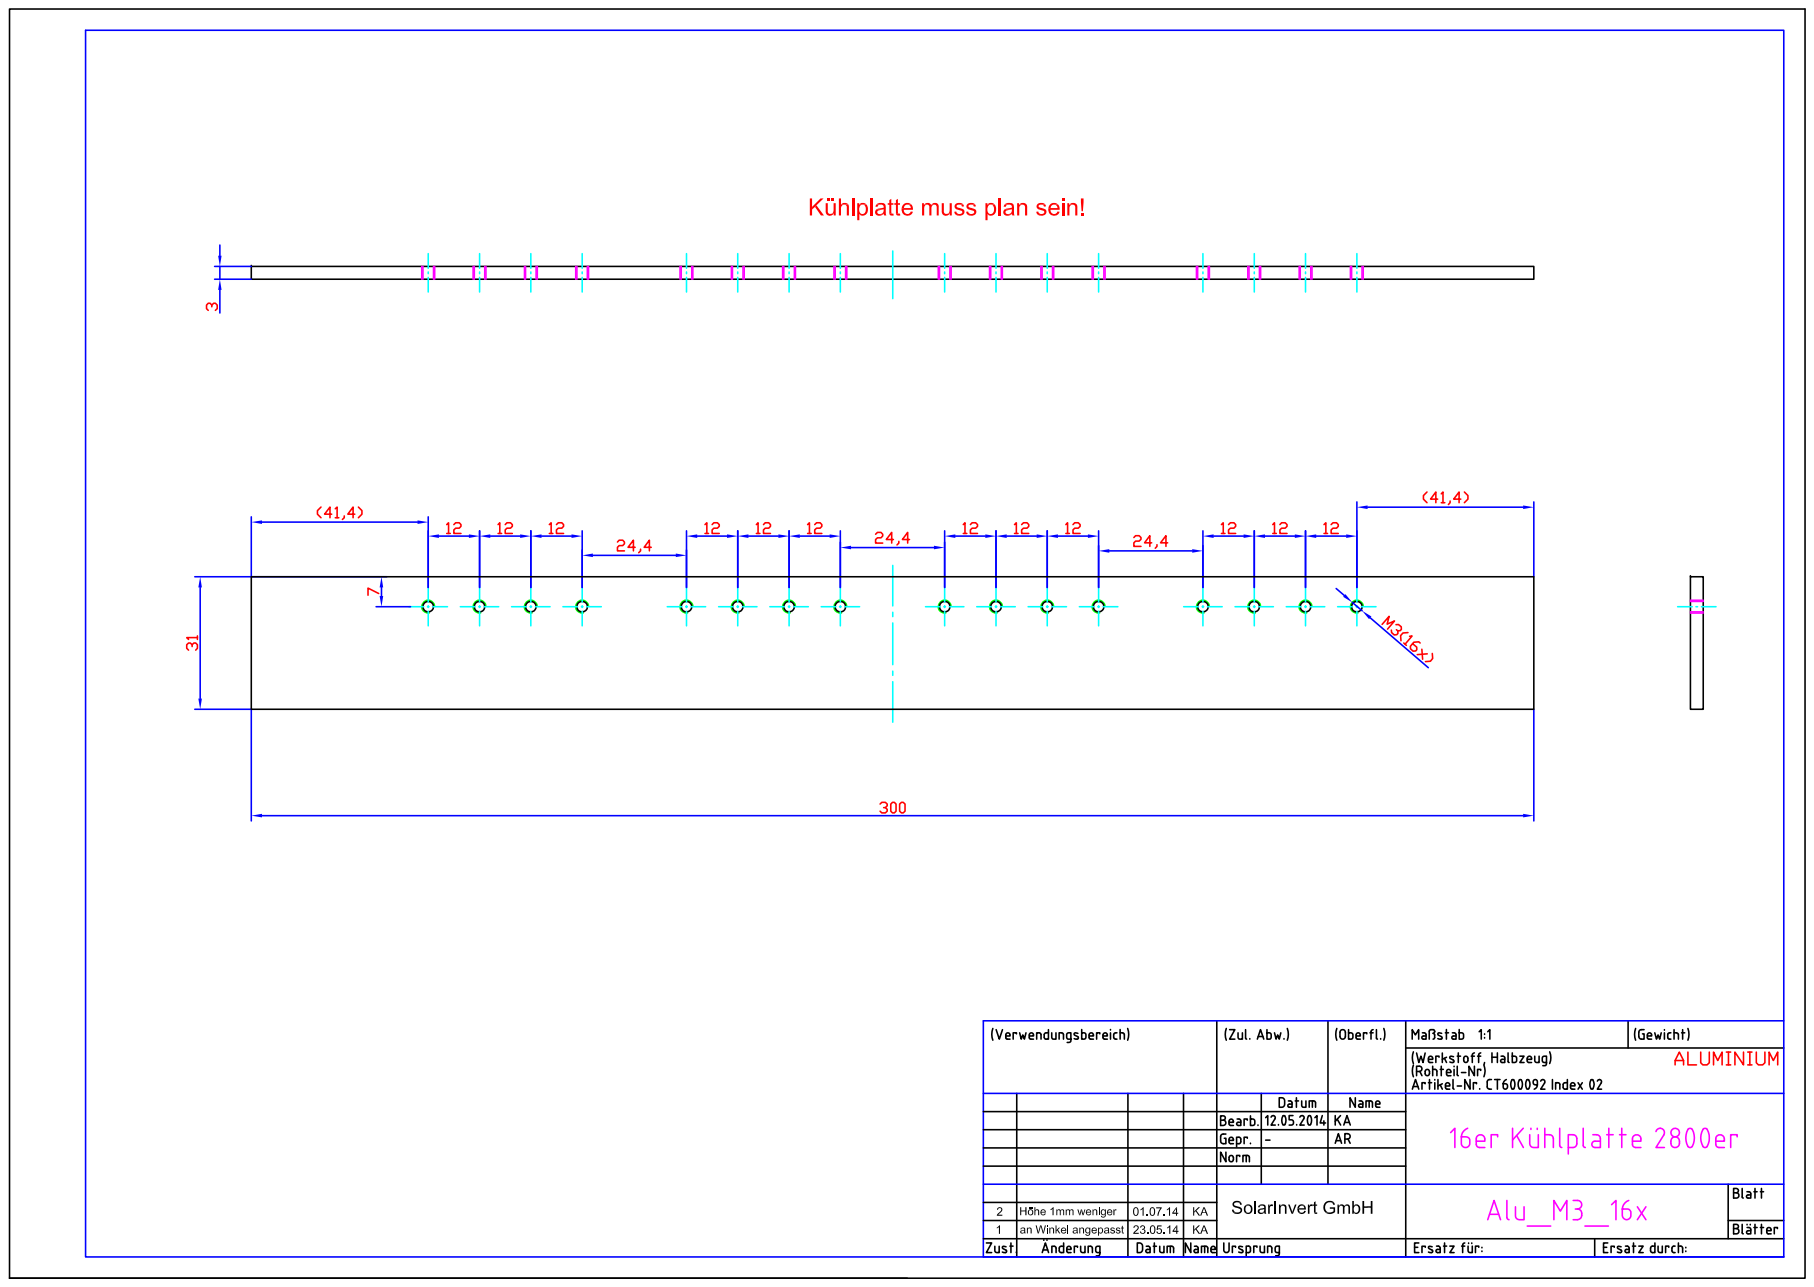
[picture p12: page 1]
