SolarInvert-GmbH/inverter_assemblies--powerboard/KICAD/SI3002V4.1.kicad_pcb

## KiCad design KICAD/SI3002V4.1.kicad_pcb (2023-05-11)

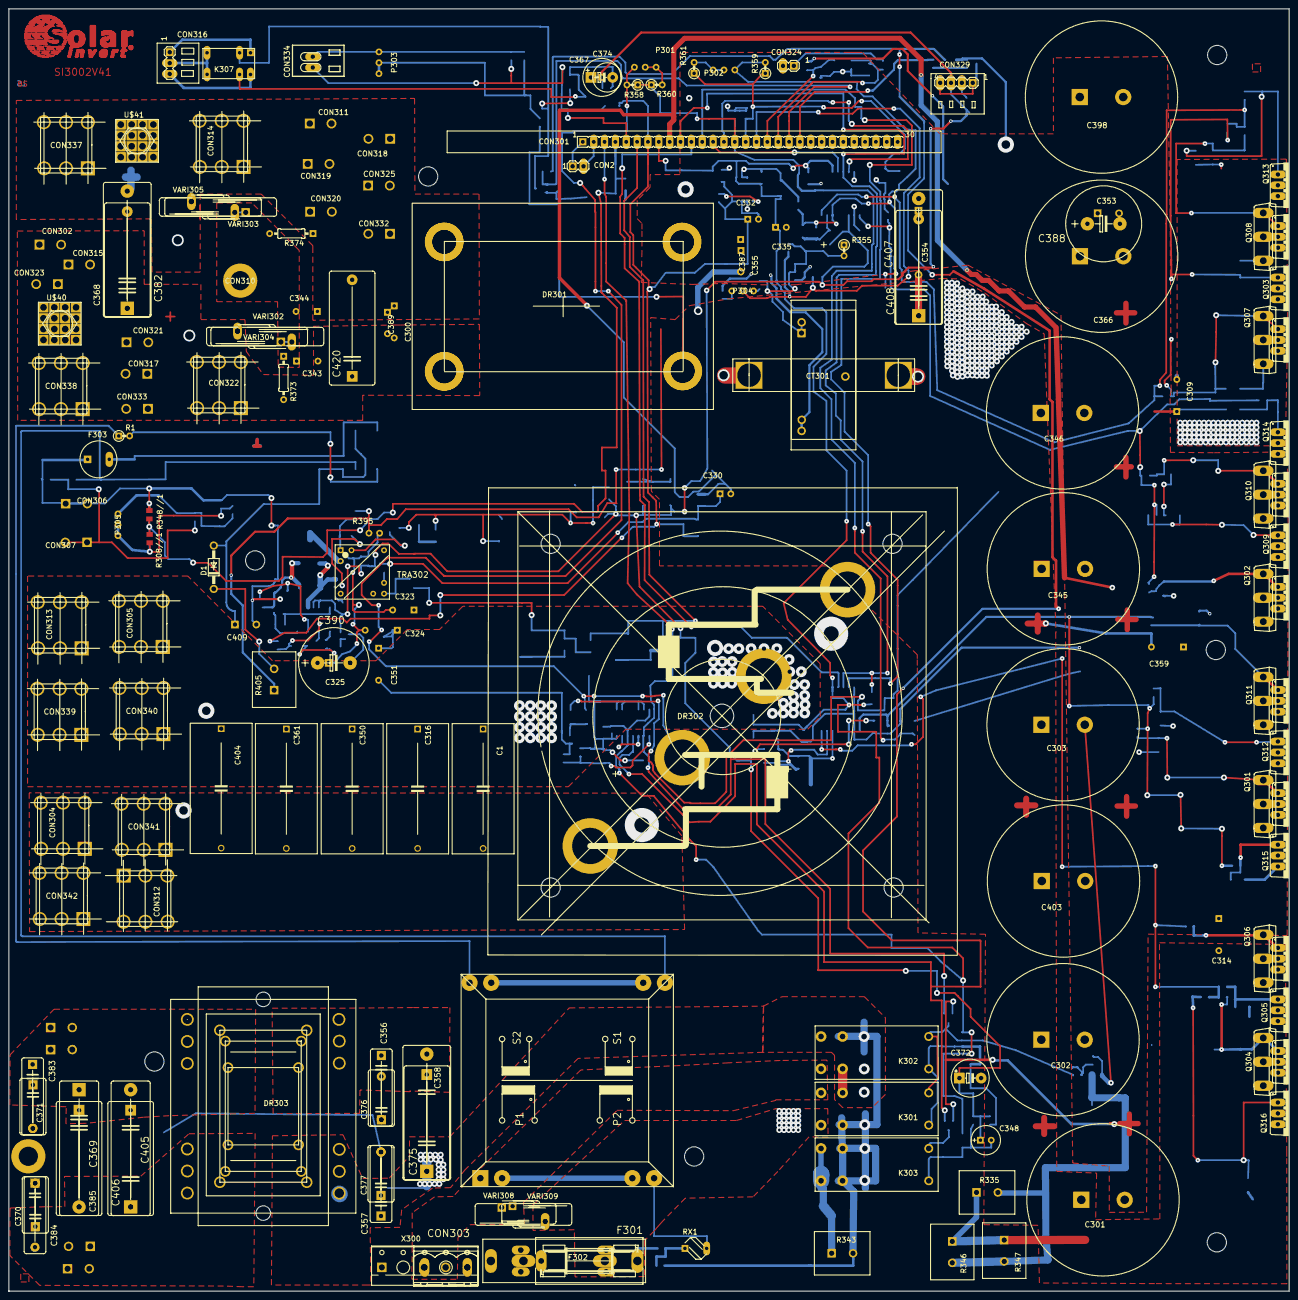
[picture p13: board SI3002V4.1.kicad_pcb from above]

Board: 16 copper layers, 299.6 x 300.0 mm, 330 parts (0 on the bottom side), 120 nets.

Parts:
@HOLE0, @HOLE1, @HOLE2, @HOLE3, @HOLE4, @HOLE5, @HOLE6: (no value)
B1: DB?GLS20; DBS
C1, C316, C361, C404: 22µF/63V; C-27,5
C300, C355, C359: 100nF/250V; KOND_RM7.5
C301, C302, C303, C345, C346, C366, C398, C403: 5600µF/100V; KOND_D35
C304: 10µ/10V; SMD-C-TANTAL-MITTEL
C305, C306, C308, C311, C312, C315, C342, C349: 100nF/63V; C1206
C307: 2,2µF / 20V Tantal; SMC_B
C309, C314: 10nF/250V; KOND_RM7.5
C310: 10µF/10V; SMD-C-TANTAL-MITTEL
C313: 2,2µF/20V Tantal; SMC_B
C318: 330n/50V; C1206
C319: 330p/50V; C0805
C320: 10n/50V; C0805
C321, C327, C329, C333, C334, C337, C339: 100n/63V; C1206
C322: 1n/50V; C0805
C323: 1nF/100V; KOND_RM5
C324: 100n/250V; KOND_RM7.5
C325, C409: 100µF/160V; ELKO_RM5
C326, C328, C336, C338, C340, C341: 22µ/20V; SMD-C-TANTAL
C330, C332, C335: 100µ/20V; ELKO_RM2.5
C331: 100n/250V; C1206
C343, C344: 100n/200V; KOND_RM5
C348, C367: 100µF/20-25V; E2,5-7
C350: 22µ/63V; C-27,5
C351: 100nF/100V; KOND_RM7.5
C352: 1µF/20V Tantal; SMC_A
C353: 100µF/100V; ELKO_RM5
C354: 1µF/100V; KOND_RM15
C356, C357: 4,7nF Y1; C15B5
C358, C368, C385, C405, C408, C420: 330nF X1; C22.5B10
C360: 47n/63V; C1206
C369, C406: 330nF X1; C27.5B9
C370, C371, C376, C377: 4n7 X1 500VAC; C10B6
C372: 220µF/25V; E5-8,5
C374: 100µF/20-25V; E5-8,5
C375: 330nF X1; C27.5B11
C378, C379: 100nF/50V; C1206
C380, C381: ???; C0805
C382, C407: 680nF X1; C27.5B11
C383, C384: 4,7nF X1; C15B5
C386: unbest.; C0805
C387, C389: 100nF/250V; KOND_RM5
C388: 100uF/160V; E7,5-18
C390: C390; E7,5-16
C391: 10n/200V X7R; C1206
C392, C396, C397, C419: C-EUC2220K; C2220K
C399, C400, C401, C402: C-EUC1210; C1210
CON2, CON324: 2pol.Stiftl.; MA02-1
CON301: µC-Platine; FE20
CON302, CON311, CON315, CON317, CON318, CON319, CON323, CON325, CON332, CON333: Steckzunge breit; KONTAKT_GROß
CON303: MSTB03; MSTB-03
CON304, CON305, CON312, CON313, CON314, CON322, CON337, CON338, CON339, CON340, CON341, CON342: POWERCLAMP2; POWERCLAMP
CON306, CON307: Steckzunge klein; KONTAKT_KLEIN
CON308, CON309, CON335, CON336: Steckzunge breit; KONTAKT_KLEIN
CON310, CON330: PE-BOHRUNG; PE-KONTAKT-BOHRUNG
CON316: 3pol.Stiftl.; MA03-1
CON320, CON321: Steckzunge; KONTAKT_GROß
CON329: 4pol.Stiftl.; MA04-1
CON334: PTSA
CT301: AC1050; STROMWANDLER2
D1: 1N4004; DO41-10
D300, D302, D305, D307, D321: BZV55C18V; SMD-DIODE_STANDARD
D301, D303, D306, D308, D325, D326: BAV103; SMD-DIODE_STANDARD
D309, D310, D336, D340, D341: LL4148; SMD-DIODE_STANDARD
D311, D320: BAT46 TMMBAT46; SMD-DIODE_STANDARD
D313: BAS70; SOT23
D314, D315: BAT64; SOT23
D318, D319, D322, D323, D324, D327, D331, D332, D333, D334, D337: BZV55C18; SMD-DIODE_STANDARD
D328, D329: BZV55C4V7; SMD-DIODE_STANDARD
D330: BZV55C5V6; SMD-DIODE_STANDARD
D335: BZV55C18; SMD-DIODE_STANDARD@1
DR301: ???; DC_COIL3
DR302: SINUSDROSSEL3
DR303: 2,7mH/8A; NETZDROSSEL3
F301: ???; SH22,5A
F302: SICHERUNGSHALTER
F303: Bürklin 50G362; TR5
IC301, IC302: IR2110S; SO-16L
IC305: UC2843D; SO-14
IC307: 4093; SO14
K301, K302, K303: RT444012; RT2N_O
K307: G5V1
L300, L302: 22µH/145mA; C1210
L301: 22µH, 260mA; C1812
P301, P302, P303, P304: 22k; POTI2
P305: 100R; POTI2
Q301, Q302, Q304, Q306, Q307, Q308, Q310, Q311: FDP2532; TO247_220
Q303, Q305, Q309, Q312, Q313, Q314, Q315, Q316: FDP2532; TO220BV
R1: 5R1 / 0,6W; 0207_2V
R300, R304, R305, R327, R328, R329, R330, R350, R351, R352, R362, R391, R392, R393, R394: 22; R0805
R301: 22R; R0805
R302, R306, R312, R320, R363: 100k; R0805
R308, R308//1: 1.5k; R0805
R309, R316, R332, R354, R366, R369: 100k; R0805W
R310: 5K1 Typ 503 1% 0,125W; R0805
R313: 51k; R0805
R314: 330k; R0805
R315: 27k; R0805
R317: 2,7k; R0805
R319: 5R6; MINI_MELF-0204W
R333, R337, R368, R370: 10k; R0805
R334: 110k; R0805
R335: 2k2 / 5W; R_LEISTUNG_RM5
R336, R341, R372: 1M; R0805
R338, R339, R342: 120k; R0805
R340, R404: 1k; R0805
R343: 330R/5W; R_LEISTUNG_RM5
R346, R347, R405: 1k5/5W; R_LEISTUNG_RM5
R348, R348//1: je nach Trafo; R0805
R353: 1k2 / 0,25W; R1206
R355: 47R / 0,6W; 0207_2V
R356: 22K; R0805
R357: 22K; M0805
R358, R359, R360, R361: 33K / 0,6W; 0207_2V
R364: 1M; R0805W
R365, R367: 10K; R0805W
R371, R375, R382, R383: 10K; R0805
R373, R374: 100k; 0207_10
R376, R377, R378, R396, R397: 0R; R0805
R379: 10R; R0805
R380: 39R; R0805
R381: 270R; R0805
R384: 100R; R0805
R395: 10R; R_RM2.5
R403: 27K; R0805
RX1: Bü 82 E 3562; B57164
T301, T304, T305, T311: BSS123; SOT23
T306: IRFL214; D2PACK
T307: IRFL214; SOT223R_INFINEON
T312: IRFL214; TRANS_5.5X9
TRA300: RINGKERN
TRA302: HFTRRM5; TRA-RM5
U301: MIC5201-5,0BM; SO-8
U$40, U$41: CONWUERTH_7461097
VARI302, VARI303: S25K130E4R12; S25K40
VARI304, VARI305: S25K130E4R12; S20K40
VARI308: S20K275
VARI309: S20K275; S10K300
X300: W237-146

Connections:
+5V: C304.+, C305.2, C310.+, C311.2, C334.2, C335.+, C349.2, C360.1, CON301.8, D311.+1, D320.+1, IC301.11, IC302.11, IC307.5, IC307.14, U301.1
+7,5V: C332.+, C333.2, CON301.7, D340.+1, L301.2, R312.2, R376.2, U301.8
+15V: C308.2, C315.2, C321.2, C328.+, C329.2, C341.+, C348.+, C367.+, C372.+, C374.+, CON329.3, D301.+1, D306.+1, D335.-2, IC301.3, IC302.3, IC305.11, IC305.12, L300.2, R310.2, R316.1, R333.2, R353.2, R354.1, R368.2
-7,5V: C338.-, C339.1, CON301.6, L302.2
/ANA: C379.1, CON301.19, R366.1, R367.2
/ANALOG: CON324.1, R366.2
/DBRÜCKE1: C306.1, C307.-, D300.+1, D303.-2, D321.+1, D325.+1, D334.+1, D337.+1, DR302.4, IC301.6, P301.U, Q301.D, Q301.D1, Q304.S, Q304.S1, Q305.S, Q306.S, Q306.S1, Q311.D, Q311.D1, Q312.D, Q315.D, Q316.S, R338.2, R358.2
/DBRÜCKE2: C312.1, C313.-, CT301.S2, D305.+1, D308.-2, D318.+1, D323.+1, D326.+1, D332.+1, IC302.6, P302.U, Q302.D, Q302.D1, Q303.S, Q307.S, Q307.S1, Q308.S, Q308.S1, Q309.D, Q310.D, Q310.D1, Q313.S, Q314.D, R339.2, R359.2
/EXT.REL: CON301.20, R369.2, R375.1, T304.L
/L1: CON303.3, F301.2, F302.P$3, F302.P$4, F302.P$7, F302.P$8, X300.3
/LED2: CON301.21, R371.1
/N1: CON303.1, CON303.2, K301.14, K302.24, TRA300.1, VARI308.1, VARI309.1, X300.2
/N$31: CON307.1, CON307.2, R384.1, R403.1, R404.1
/OVER: C378.1, CON301.18, R364.1, R365.2
/PE1: C356.2, C357.2, C370.2, C371.2, C376.1, C377.2, C383.2, C384.1, CON330.0
/RDSON_M1: C381.1, CON301.15, D303.+1, D328.-2, R358.1, R360.1
/RDSON_M2: C380.1, CON301.16, D308.+1, D329.-2, R359.1, R361.1
/REL: CON301.3, IC307.2, R309.2, T305.L
/RT/CT: C319.2, IC305.7, R315.1, R320.1
/SD: C360.2, CON301.10, IC301.13, IC302.13
/T301-ANS: CON301.11, IC301.12
/T302-ANS: CON301.12, IC301.14
/T303-ANS: CON301.13, IC302.12
/T304-ANS: CON301.14, IC302.14
/TRA_L: C369.1, C371.1, C383.1, C385.1, C405.1, C406.2, CON308.1, CON308.2, CON335.1, CON335.2, DR303.P$2, DR303.P$6, DR303.P$10, DR303.P$11, DR303.P$14, DR303.P$18, DR303.P$19
/TRA_N: C369.2, C370.1, C384.2, C385.2, C405.2, C406.1, CON309.1, CON309.2, CON336.1, CON336.2, DR303.P$4, DR303.P$8, DR303.P$12, DR303.P$15, DR303.P$20, DR303.P$21
/UN: C342.2, CON301.4, R308.1, R308//1.1, R348.2, R348//1.2
GND: C301.-, C302.-, C303.-, C304.-, C305.1, C308.1, C309.1, C310.-, C311.1, C314.1, C315.1, C319.1, C320.1, C321.1, C322.1, C323.1, C324.1, C325.-, C326.-, C327.1, C328.-, C329.1, C330.-, C331.1, C332.-, C333.1, C334.1, C335.-, C336.+, C337.2, C338.+, C339.2, C340.-, C341.-, C342.1, C345.-, C346.-, C349.1, C351.1, C352.-, C353.-, C354.1, C355.1, C359.1, C366.-, C378.2, C379.2, C380.2, C381.2, C386.2, C387.1, C388.-, C390.-, C391.1, C398.-, C403.-, C407.2, C408.2, C409.-, CON301.9, CON306.1, CON306.2, CON324.2, CT301.3, CT301.P$2, D302.+1, D307.+1, D319.+1, D322.+1, D324.+1, D327.+1, D328.+1, D329.+1, D330.+1, D331.+1, D333.+1, D335.+1, DR301.1B, DR301.11B, F303.1, IC301.2, IC301.15, IC302.2, IC302.15, IC305.8, IC305.9, IC307.7, IC307.8, IC307.9, IC307.12, IC307.13, Q301.S, Q301.S1, Q302.S, Q302.S1, Q309.S, Q310.S, Q310.S1, Q311.S, Q311.S1, Q312.S, Q314.S, Q315.S, R302.1, R306.1, R309.1, R313.1, R319.1, R332.1, R336.1, R338.1, R339.1, R342.1, R348.1, R348//1.1, R355.1, R357.2, R363.1, R365.1, R367.1, R369.1, R372.1, R381.2, R383.2, R404.2, T301.R, T304.R, T305.R, T311.R, T312.S, TRA302.3, U301.2, U301.3, U301.6, U301.7
unnamed: B1.+, C409.+, D1.A
unnamed: B1.-, F303.2
unnamed: B1.AC1, R403.2, TRA300.5
unnamed: B1.AC2, R1.2
unnamed: C1.1, C316.1, C350.1, C361.1, C392.2, C396.2, C397.2, C399.2, C400.2, C401.2, C402.2, C404.1, C419.2, CON305.1, CON305.2, CON305.3, CON305.4, CON305.5, CON305.6, CON313.1, CON313.2, CON313.3, CON313.4, CON313.5, CON313.6, CON339.1, CON339.2, CON339.3, CON339.4, CON339.5, CON339.6, CON340.1, CON340.2, CON340.3, CON340.4, CON340.5, CON340.6, DR302.2
unnamed: C1.2, C316.2, C350.2, C361.2, C392.1, C396.1, C397.1, C399.1, C400.1, C401.1, C402.1, C404.2, C419.1, CON304.1, CON304.2, CON304.3, CON304.4, CON304.5, CON304.6, CON312.1, CON312.2, CON312.3, CON312.4, CON312.5, CON312.6, CON341.1, CON341.2, CON341.3, CON341.4, CON341.5, CON341.6, CON342.1, CON342.2, CON342.3, CON342.4, CON342.5, CON342.6, DR302.33
unnamed: C300.1, C344.1, C368.2, C382.2, C389.1, C420.2, CON311.1, CON311.2, CON314.1, CON314.2, CON314.3, CON314.4, CON314.5, CON314.6, CON318.1, CON318.2, CON319.1, CON319.2, CON320.1, CON320.2, CON325.1, CON325.2, CON332.1, CON332.2, CON337.1, CON337.2, CON337.3, CON337.4, CON337.5, CON337.6, DR301.1A, DR301.11A, R374.1, U$41.P$1, U$41.P$2, U$41.P$3, U$41.P$4, U$41.P$5, U$41.P$6, U$41.P$7, U$41.P$8, U$41.P$9, U$41.P$10, U$41.P$11, U$41.P$12, U$41.P$13, U$41.P$14, U$41.P$15, U$41.P$16, VARI303.2, VARI305.1
unnamed: C300.2, C343.2, C368.1, C382.1, C389.2, C420.1, CON302.1, CON302.2, CON315.1, CON315.2, CON317.1, CON317.2, CON321.1, CON321.2, CON322.1, CON322.2, CON322.3, CON322.4, CON322.5, CON322.6, CON323.1, CON323.2, CON333.1, CON333.2, CON338.1, CON338.2, CON338.3, CON338.4, CON338.5, CON338.6, DR301.2A, DR301.22A, R373.2, U$40.P$1, U$40.P$2, U$40.P$3, U$40.P$4, U$40.P$5, U$40.P$6, U$40.P$7, U$40.P$8, U$40.P$9, U$40.P$10, U$40.P$11, U$40.P$12, U$40.P$13, U$40.P$14, U$40.P$15, U$40.P$16, VARI302.1, VARI304.2
unnamed: C301.+, C302.+, C303.+, C309.2, C314.2, C345.+, C346.+, C353.+, C354.2, C355.2, C359.2, C366.+, C387.2, C388.+, C398.+, C403.+, C407.1, C408.1, DR301.2B, DR301.22B, Q303.D, Q304.D, Q304.D1, Q305.D, Q306.D, Q306.D1, Q307.D, Q307.D1, Q308.D, Q308.D1, Q313.D, Q316.D, R334.2, R335.1, R346.1, R347.1, R364.2, R379.2, R395.P$2, R405.1
unnamed: C306.2, C307.+, D301.-2, IC301.7
unnamed: C312.2, C313.+, D306.-2, IC302.7
unnamed: C318.1, R314.2
unnamed: C318.2, IC305.3, R312.1, R313.2
unnamed: C320.2, IC305.14, R315.2
unnamed: C322.2, IC305.5, R317.1
unnamed: C323.2, C324.2, C325.+, C390.+, C391.2, R316.2, R354.2, R379.1, R395.P$1, TRA302.1
unnamed: C326.+, C327.2, C340.+, D313.M, L300.1
unnamed: C330.+, C331.2, D314.M, L301.1
unnamed: C336.-, C337.1, D315.L, L302.1
unnamed: C343.1, C344.2, CON310.0, R373.1, R374.2, VARI302.2, VARI303.1, VARI304.1, VARI305.2
unnamed: C348.-, D309.-2, D320.-2, K303.A2, R333.1
unnamed: C351.2, R340.1, R341.2
unnamed: C352.+, D330.-2, IC307.1, R341.1, R342.2
unnamed: C356.1, C358.1, C375.2, C376.2, DR303.P$1, DR303.P$5, DR303.P$9, DR303.P$16, DR303.P$22, DR303.P$23, K303.14, K303.24, R343.1
unnamed: C357.1, C358.2, C375.1, C377.1, DR303.P$3, DR303.P$7, DR303.P$13, DR303.P$17, DR303.P$24, DR303.P$25, K301.11, K302.21
unnamed: C367.-, C374.-, D336.-2, D341.-2, K307.9, R368.1
unnamed: C372.-, D310.-2, D311.-2, K301.A2, K302.A2, R310.1
unnamed: C386.1, CT301.1, CT301.P$1, R355.2, R356.1, R382.1
unnamed: CON2.1, CON301.1
unnamed: CON2.2, CON301.2
unnamed: CON301.5, CON334.P$2, R378.1
unnamed: CON301.17, P304.M, R356.2, R357.1
unnamed: CON316.1, K307.1
unnamed: CON316.2, K307.5, K307.6
unnamed: CON316.3, K307.10
unnamed: CON329.1, CON329.4, T301.M
unnamed: CON329.2, R353.1
unnamed: CON334.P$1, P303.O, R377.1, R378.2
unnamed: CT301.S1, DR302.11
unnamed: D1.C, R405.2
unnamed: D300.-2, Q305.G, R300.1
unnamed: D302.-2, Q311.G, Q311.G1, R301.1
unnamed: D305.-2, Q307.G, Q307.G1, R304.1
unnamed: D307.-2, Q309.G, R305.1
unnamed: D309.+1, K303.A1, T311.M
unnamed: D310.+1, K301.A1, K302.A1, R337.2, T305.M
unnamed: D313.L, TRA302.6
unnamed: D314.L, TRA302.5
unnamed: D315.M, TRA302.4
unnamed: D318.-2, Q313.G, R391.1
unnamed: D319.-2, Q314.G, R392.1
unnamed: D321.-2, Q306.G, Q306.G1, R327.1
unnamed: D322.-2, Q312.G, R328.1
unnamed: D323.-2, Q308.G, Q308.G1, R329.1
unnamed: D324.-2, Q310.G, Q310.G1, R330.1
unnamed: D325.-2, D326.-2, R340.2
unnamed: D327.-2, Q315.G, R394.1
unnamed: D331.-2, Q301.G, Q301.G1, R362.1
unnamed: D332.-2, Q303.G, R350.1
unnamed: D333.-2, Q302.G, Q302.G1, R351.1
unnamed: D334.-2, Q304.G, Q304.G1, R352.1
unnamed: D336.+1, K307.2, T304.M
unnamed: D337.-2, Q316.G, R393.1
unnamed: D340.-2, D341.+1
unnamed: F301.1, F302.P$1, F302.P$2, F302.P$5, F302.P$6, K301.24, K302.14, R397.1, VARI308.2, VARI309.2
unnamed: IC301.1, R301.2, R302.2, R328.2, R362.2, R394.2
unnamed: IC301.8, R300.2, R327.2, R352.2, R393.2
unnamed: IC302.1, R305.2, R306.2, R330.2, R351.2, R392.2
unnamed: IC302.8, R304.2, R329.2, R350.2, R391.2
unnamed: IC305.1, R314.1
unnamed: IC305.10, R363.2, T306.1, T307.G
unnamed: IC307.3, IC307.6
unnamed: IC307.4, R332.2, R370.1, R375.2, T311.L
unnamed: K301.21, K302.11, K303.11, K303.21, R343.2, R396.1
unnamed: P301.M, P301.O, R360.2
unnamed: P302.M, P302.O, R361.2
unnamed: P303.M, P303.U, R334.1, R377.2
unnamed: P304.O, R382.2
unnamed: P304.U, R383.1
unnamed: P305.M, P305.U, R308.2, R308//1.2, R380.2, R381.1
unnamed: P305.O, R380.1, R384.2
unnamed: R1.1, TRA300.8
unnamed: R317.2, R319.2, R320.2, T306.3, T307.S
unnamed: R335.2, R346.2, R347.2, T312.D
unnamed: R336.2, R337.1, T312.GATE
unnamed: R370.2, R371.2, R372.2, T301.L
unnamed: R376.1, U301.5
unnamed: R396.2, R397.2, RX1.1
unnamed: RX1.2, TRA300.4
unnamed: T306.2, T307.4, TRA302.2
unnamed: TRA300.2, TRA300.3
unnamed: TRA300.6, TRA300.7
